pascalguttmann/obat-meas/README.md

# Obat - Measurement

KiCAD Project for the measurement electronics of Obat.

| TOP | BOT |
| --- | --- |
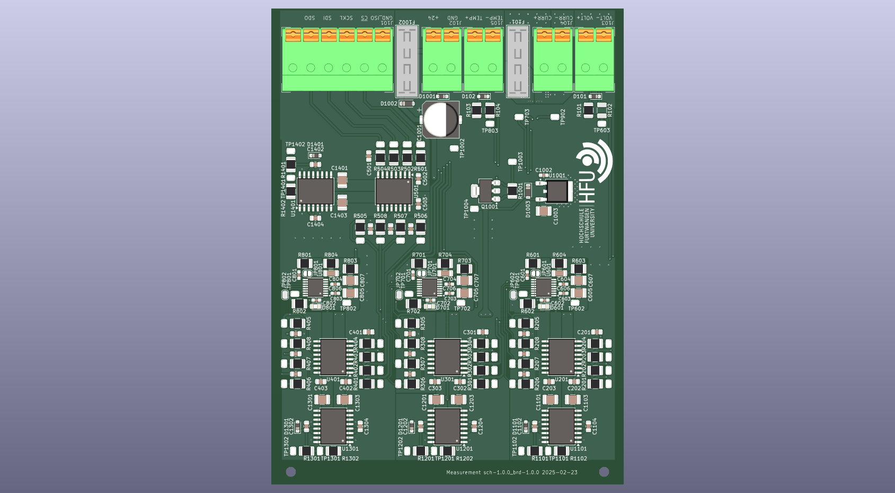
[picture p1: img/meas_top.png]
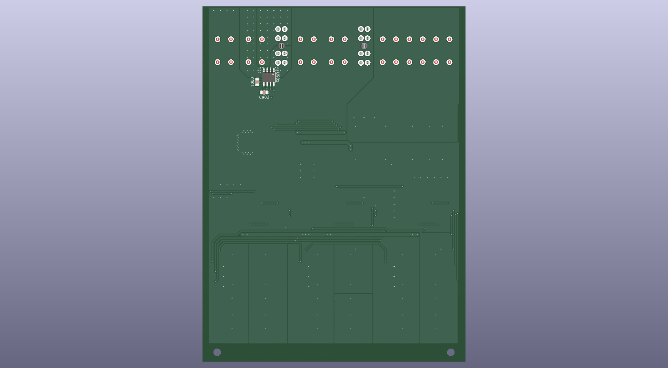
[picture p2: img/meas_bot.png]
|  |  |
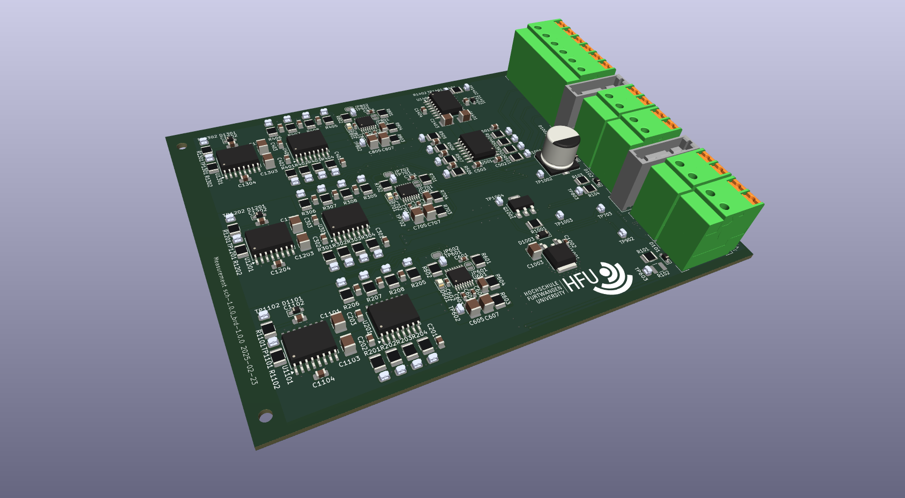
[picture p3: img/meas_3d_top.png]
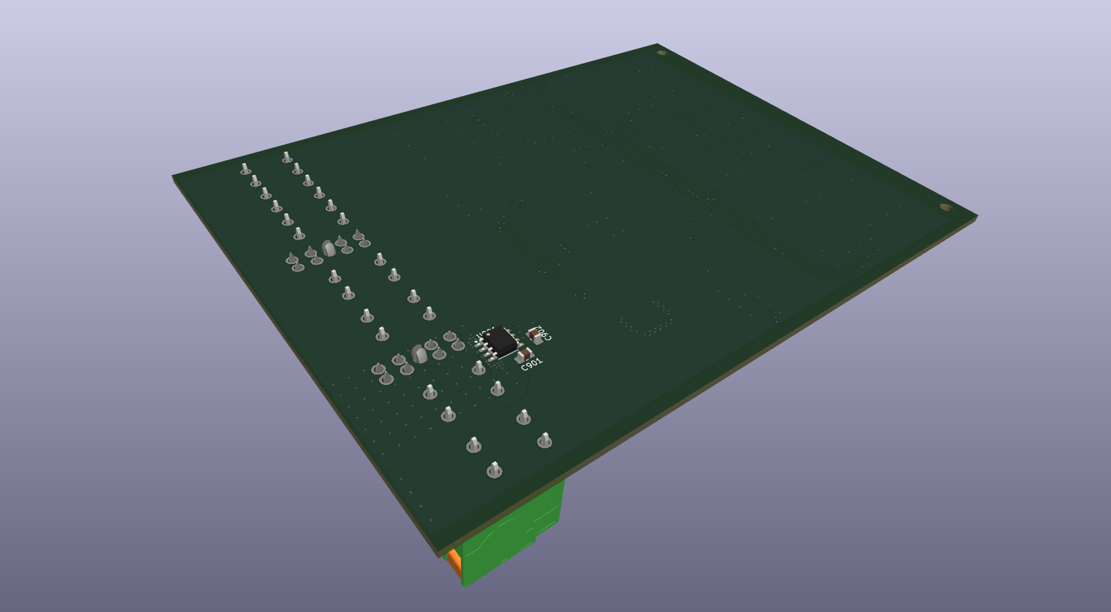
[picture p4: img/meas_3d_bot.png]
|  |  |

## License

This repository is licensed under the MIT license.
