pascalguttmann/obat-meas/3d_models/pxc_1017503_00_00_TDPT-2-5-2-SP-5-08_3D.stp

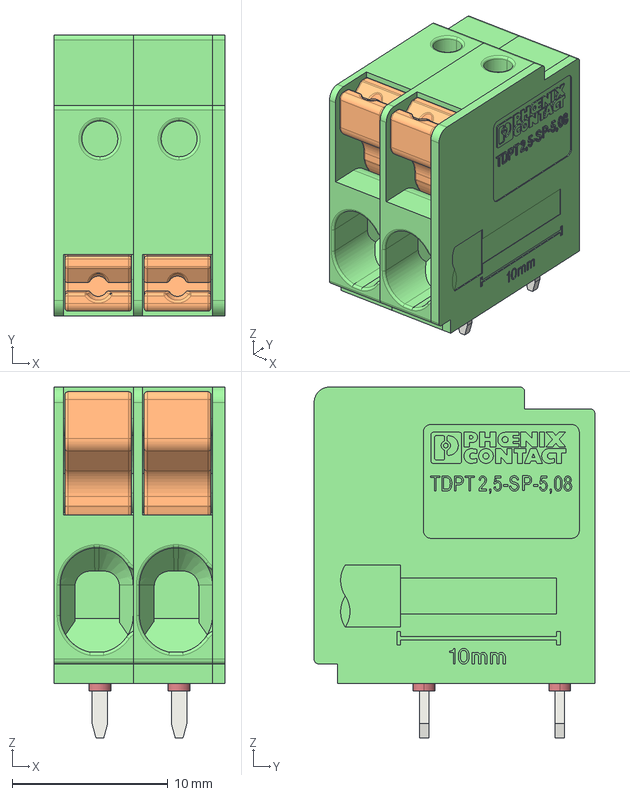
[picture p5: CAD file, 2025-02-22]
3d_models/pxc_1017503_00_00_TDPT-2-5-2-SP-5-08_3D.stp
11.0 x 18.0 x 22.5 mm
Bohrloch x 4
LP_TDPT_2_5_SP_DRST_vorne x 2
LP_TDPT_2_5_SP_DRST_hinten x 2
AC_TDPT_2_5_SP_pusher x 2
PK_TDPT_2_5_SP_GEH
PK_TDPT_2_5_SP_ENDGEH
DK_TDPT_2_5_SP
