pascalguttmann/obat-meas/3d_models/178.6165.0000.step

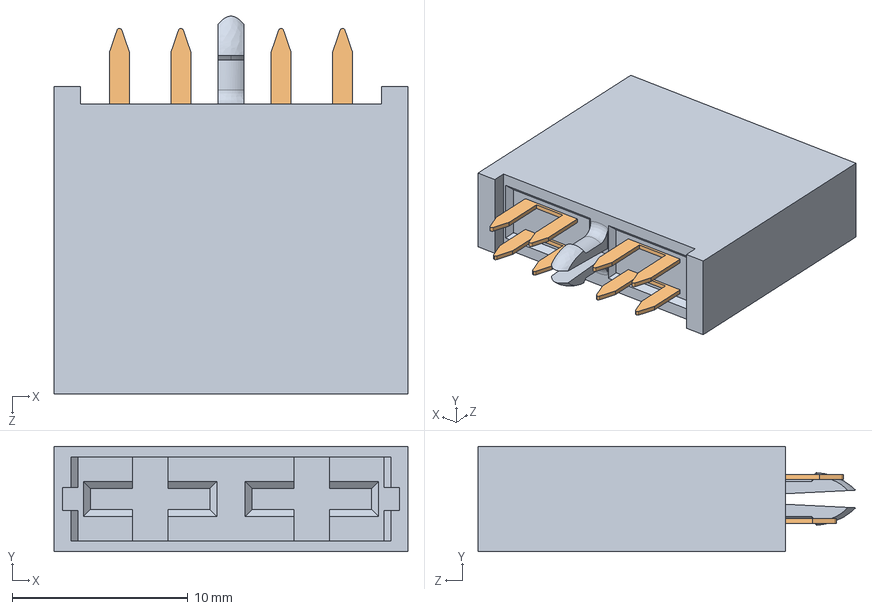
[picture p6: CAD file, 2025-02-22]
3d_models/178.6165.0000.step
20.1 x 6.00 x 21.5 mm
