pascalguttmann/obat-meas/3d_models/RCTCTE.STEP

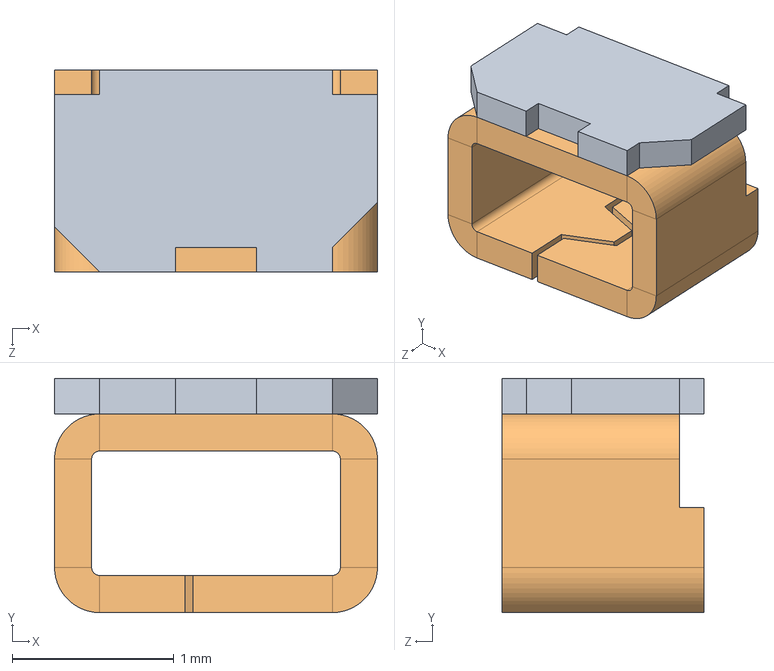
[picture p7: CAD file, 2025-02-22]
3d_models/RCTCTE.STEP
2.00 x 1.45 x 1.25 mm
