pascalguttmann/obat-meas/3d_models/pxc_1017507_00_00_TDPT-2-5-6-SP-5-08_3D.stp

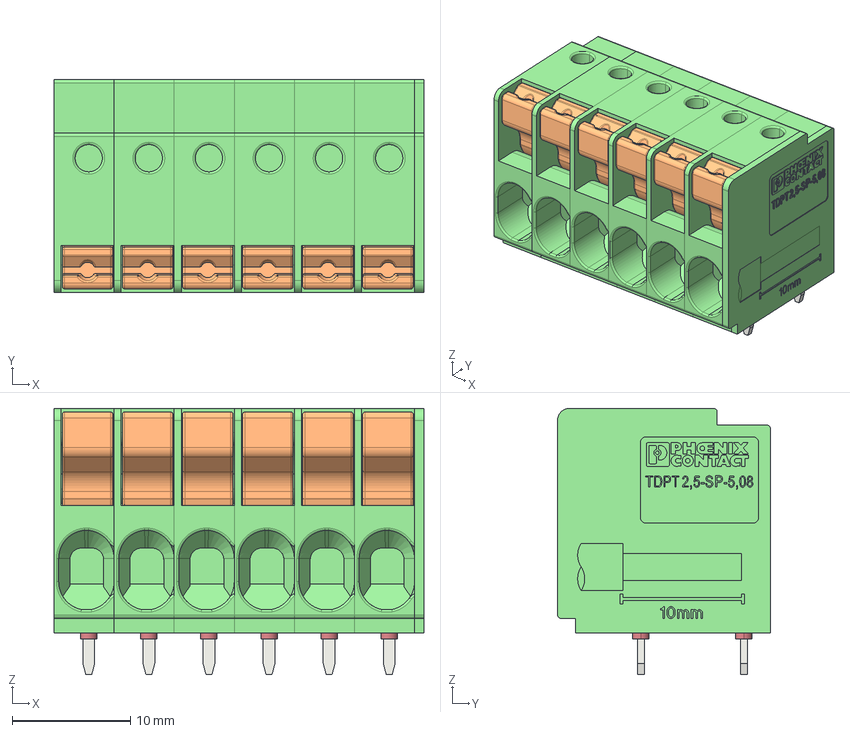
[picture p8: CAD file, 2025-02-22]
3d_models/pxc_1017507_00_00_TDPT-2-5-6-SP-5-08_3D.stp
31.3 x 18.0 x 22.5 mm
Bohrloch.2 x 12
LP_TDPT_2_5_SP_DRST_vorne.1 x 6
LP_TDPT_2_5_SP_DRST_hinten x 6
AC_TDPT_2_5_SP_pusher.1 x 6
PK_TDPT_2_5_SP_GEH x 5
PK_TDPT_2_5_SP_ENDGEH
DK_TDPT_2_5_SP
