pascalguttmann/obat-meas/schematic/meas_schematic_2.0.1.pdf

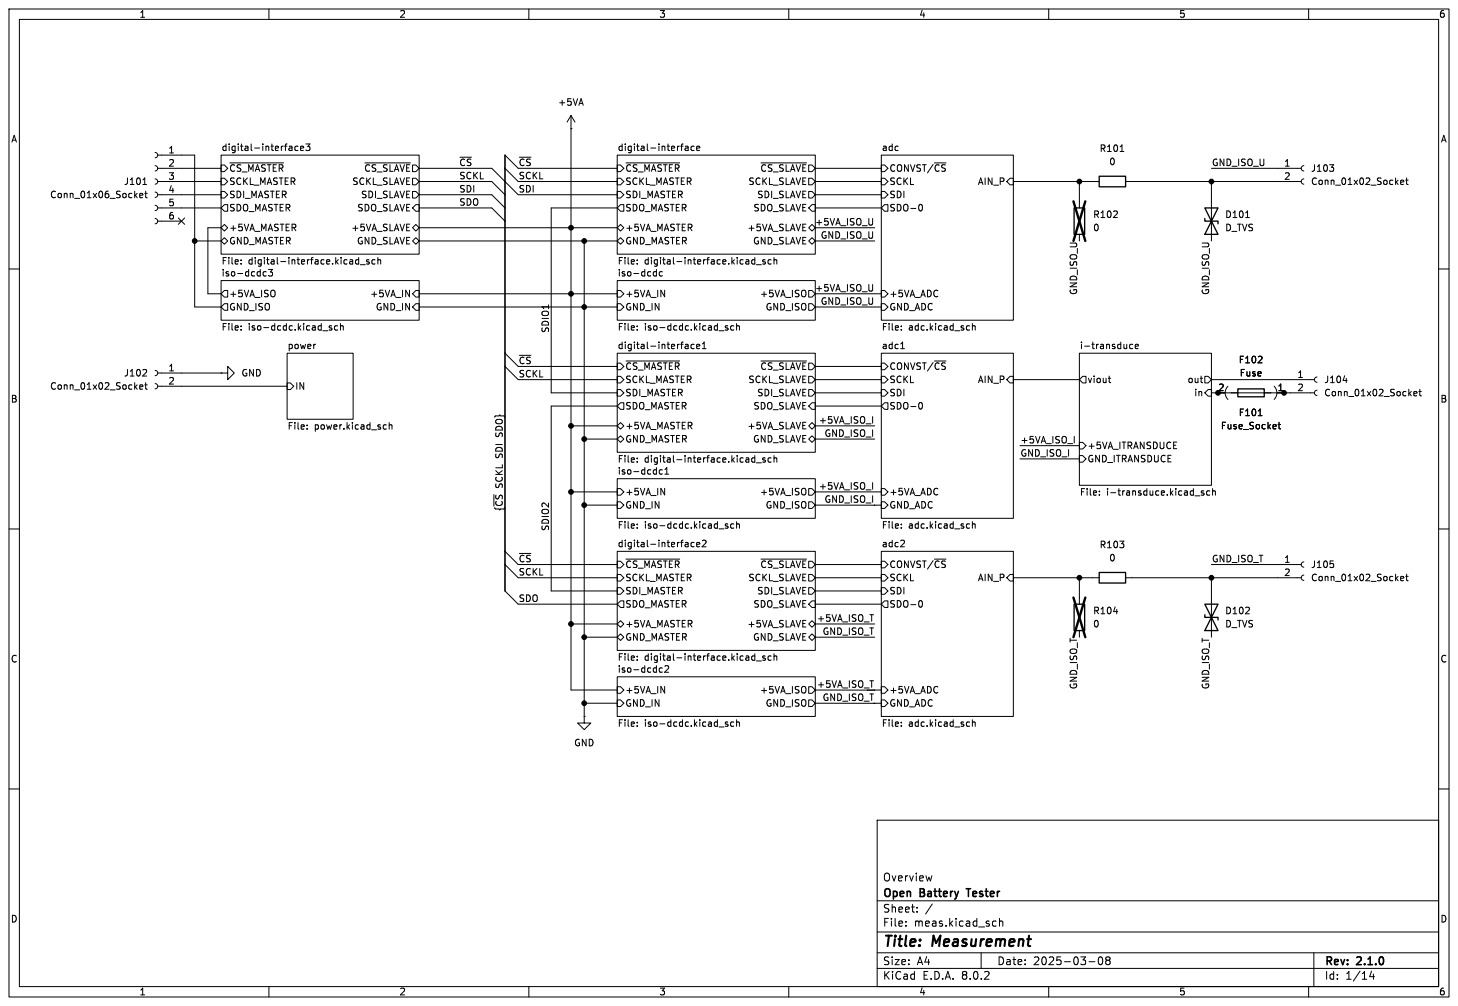
[picture p9: page 1]

SDI CONVST/~{CS} SCKL SDO-0 GND_ADC

iso-dcdc3 File: iso-dcdc.kicad_sch

+5VA_ISO_U

iso-dcdc1 File: iso-dcdc.kicad_sch

+5VA_ADC

digital-interface2 File: digital-interface.kicad_sch

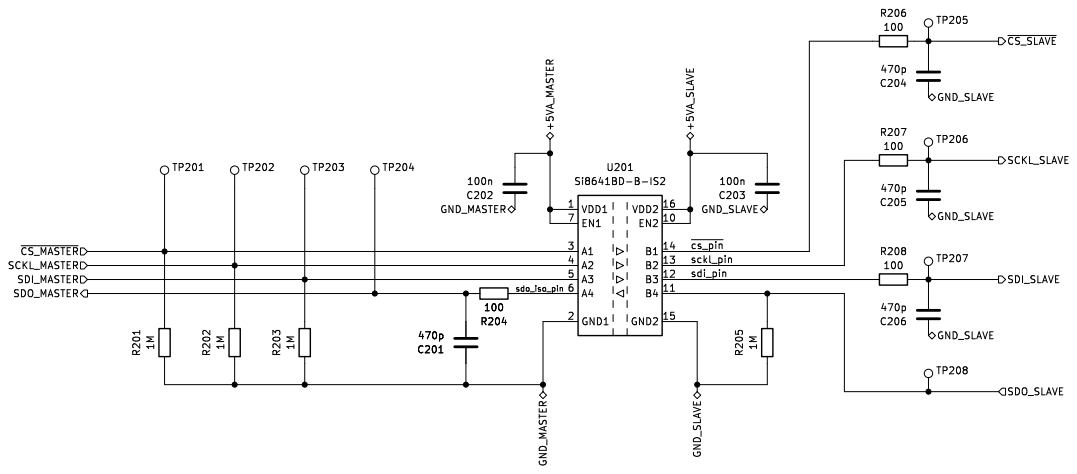
[picture p10: page 2]

Id: 2/14 Title: Measurement File: digital-interface.kicad_sch Sheet: /digital-interface/

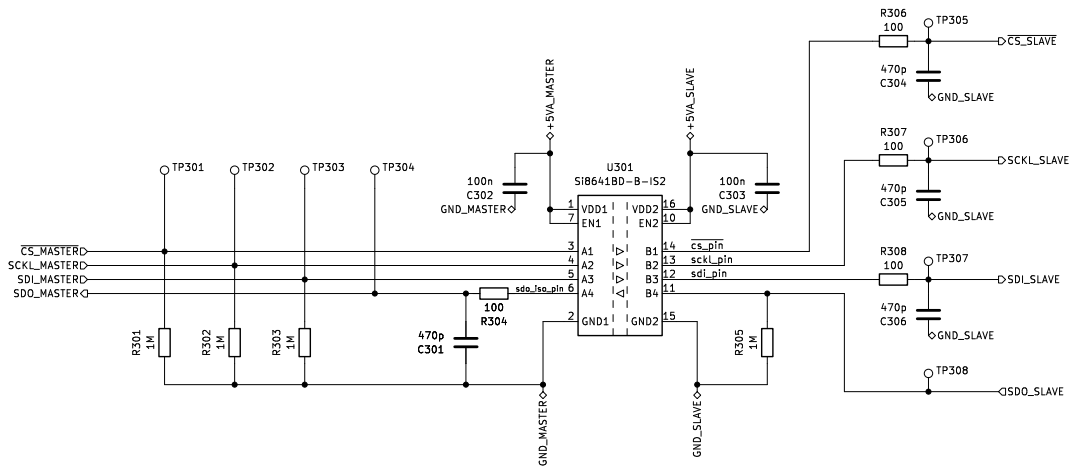
[picture p11: page 3]

Id: 3/14 Title: Measurement File: digital-interface.kicad_sch Sheet: /digital-interface1/

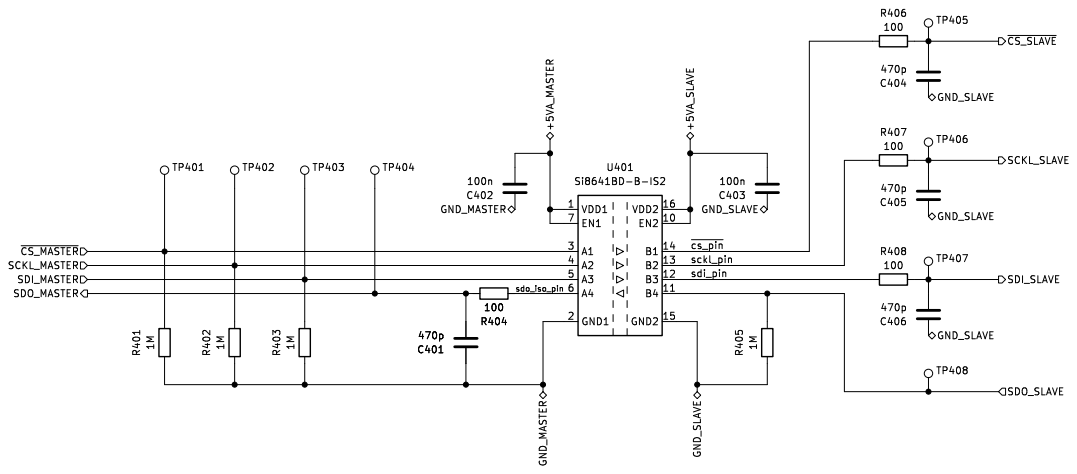
[picture p12: page 4]

Id: 4/14 Title: Measurement File: digital-interface.kicad_sch Sheet: /digital-interface2/

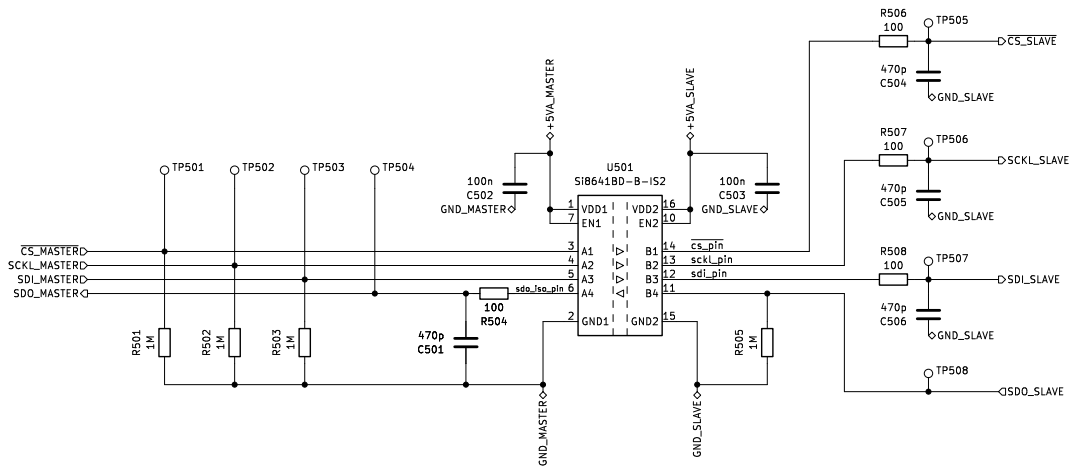
[picture p13: page 5]

Id: 5/14 Title: Measurement File: digital-interface.kicad_sch Sheet: /digital-interface3/

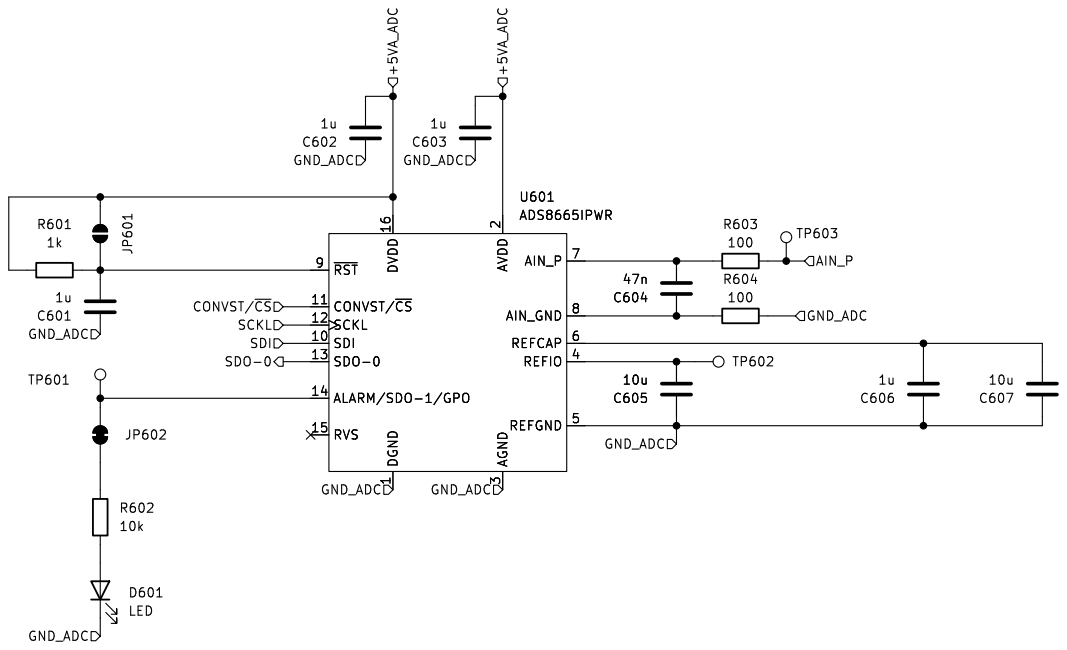
[picture p14: page 6]

3 REFIO 4 REFGND 5 REFCAP 6 AIN_P 7 AIN_GND 8 ~{RST} 9 U601 ADS8665IPWR

1 SDI 10 CONVST/~{CS} 11 SCKL 12 SDO-0 13 ALARM/SDO-1/GPO 14 RVS 15 DVDD 16 AVDD

3 REFIO 4 REFGND 5 REFCAP 6 AIN_P 7 AIN_GND 8 ~{RST} 9

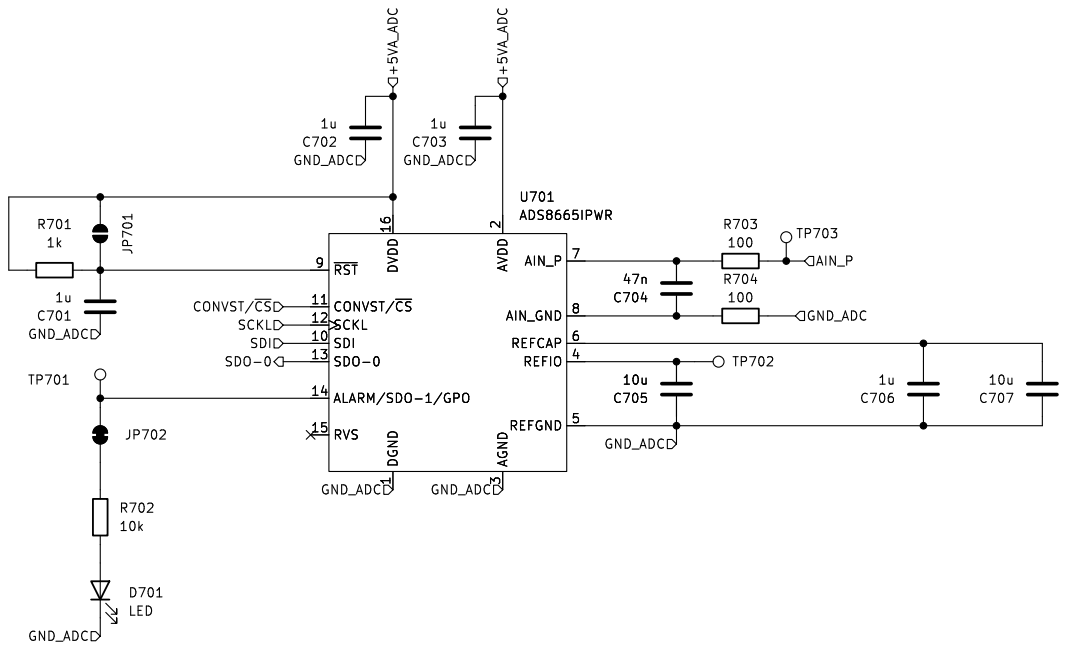
[picture p15: page 7]

3 REFIO 4 REFGND 5 REFCAP 6 AIN_P 7 AIN_GND 8 ~{RST} 9 U701 ADS8665IPWR

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

3 REFIO 4 REFGND 5 REFCAP 6 AIN_P 7 AIN_GND 8 ~{RST} 9

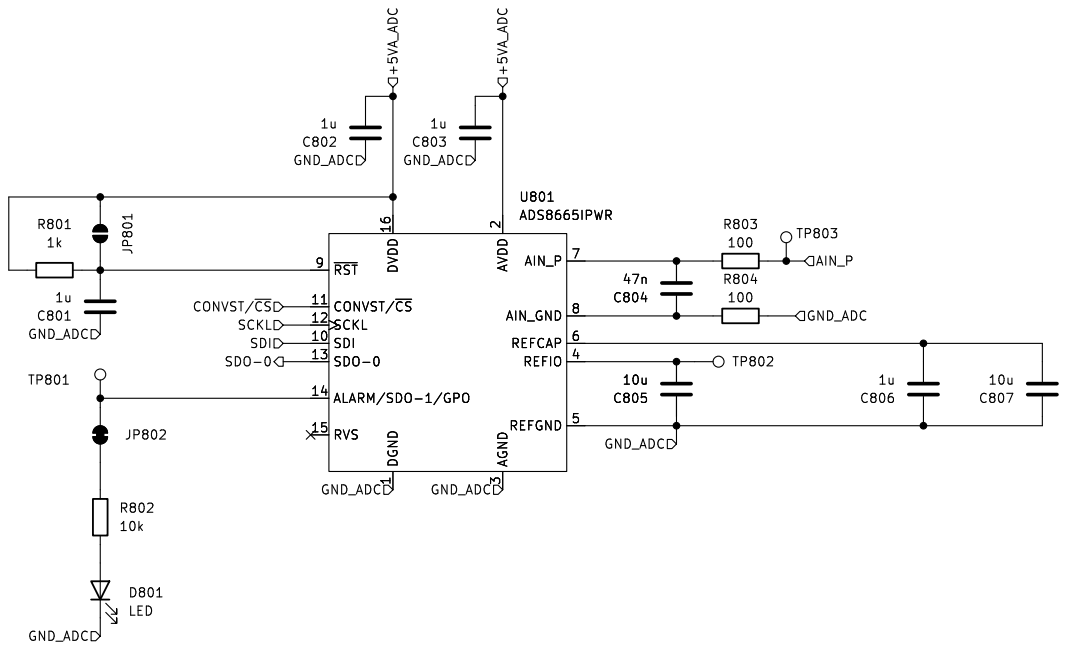
[picture p16: page 8]

3 REFIO 4 REFGND 5 REFCAP 6 AIN_P 7 AIN_GND 8 ~{RST} 9 U801 ADS8665IPWR

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

3 REFIO 4 REFGND 5 REFCAP 6 AIN_P 7 AIN_GND 8 ~{RST} 9

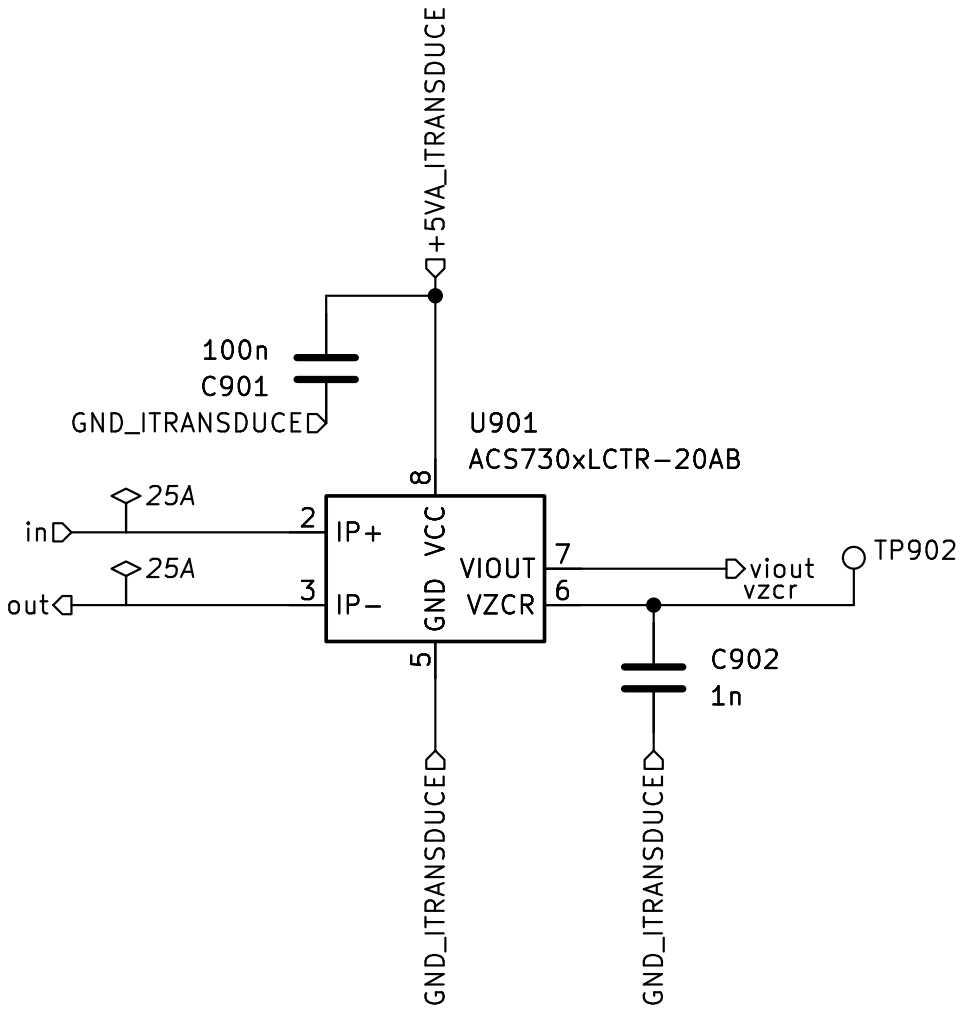
[picture p17: page 9]

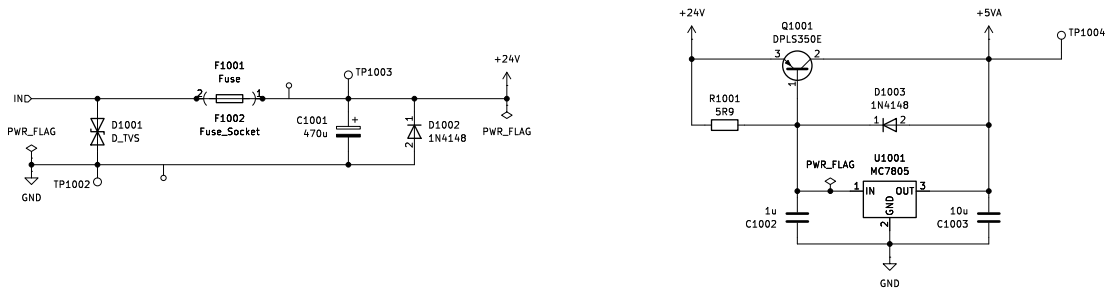
[picture p18: page 10]

Id: 10/14 Title: Measurement File: power.kicad_sch Sheet: /power/

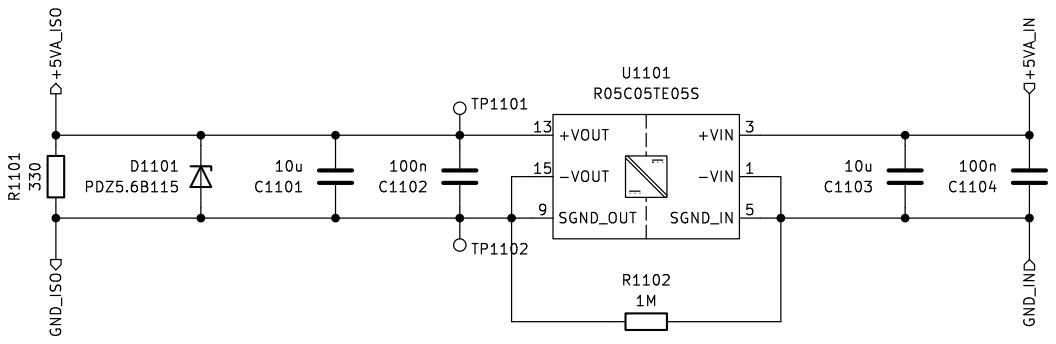
[picture p19: page 11]

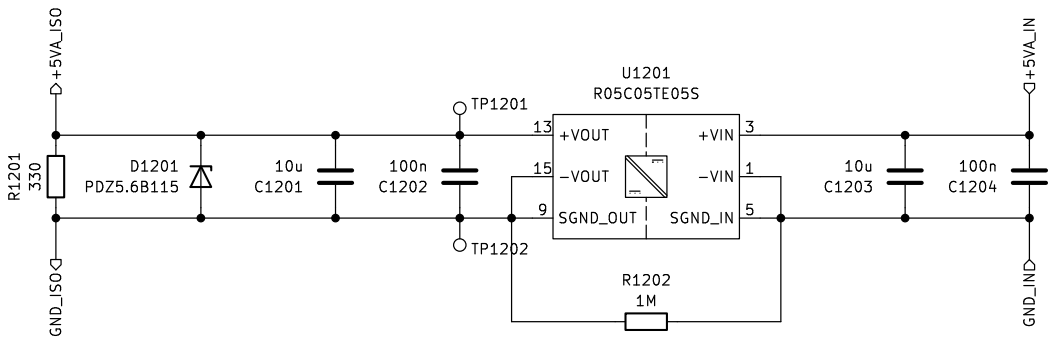
[picture p20: page 12]

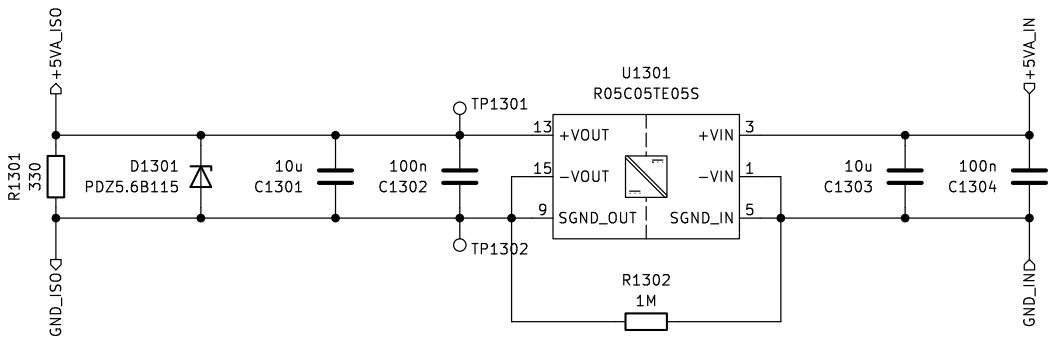
[picture p21: page 13]

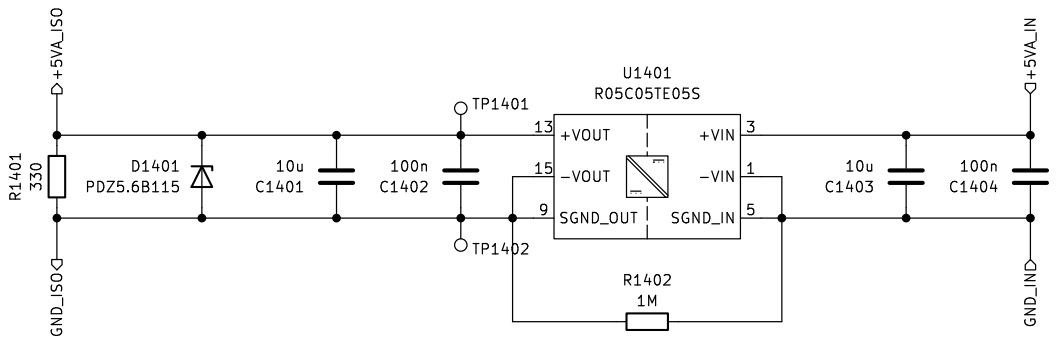
[picture p22: page 14]
