pascalguttmann/obat-meas/schematic/meas_schematic_2.0.0.pdf

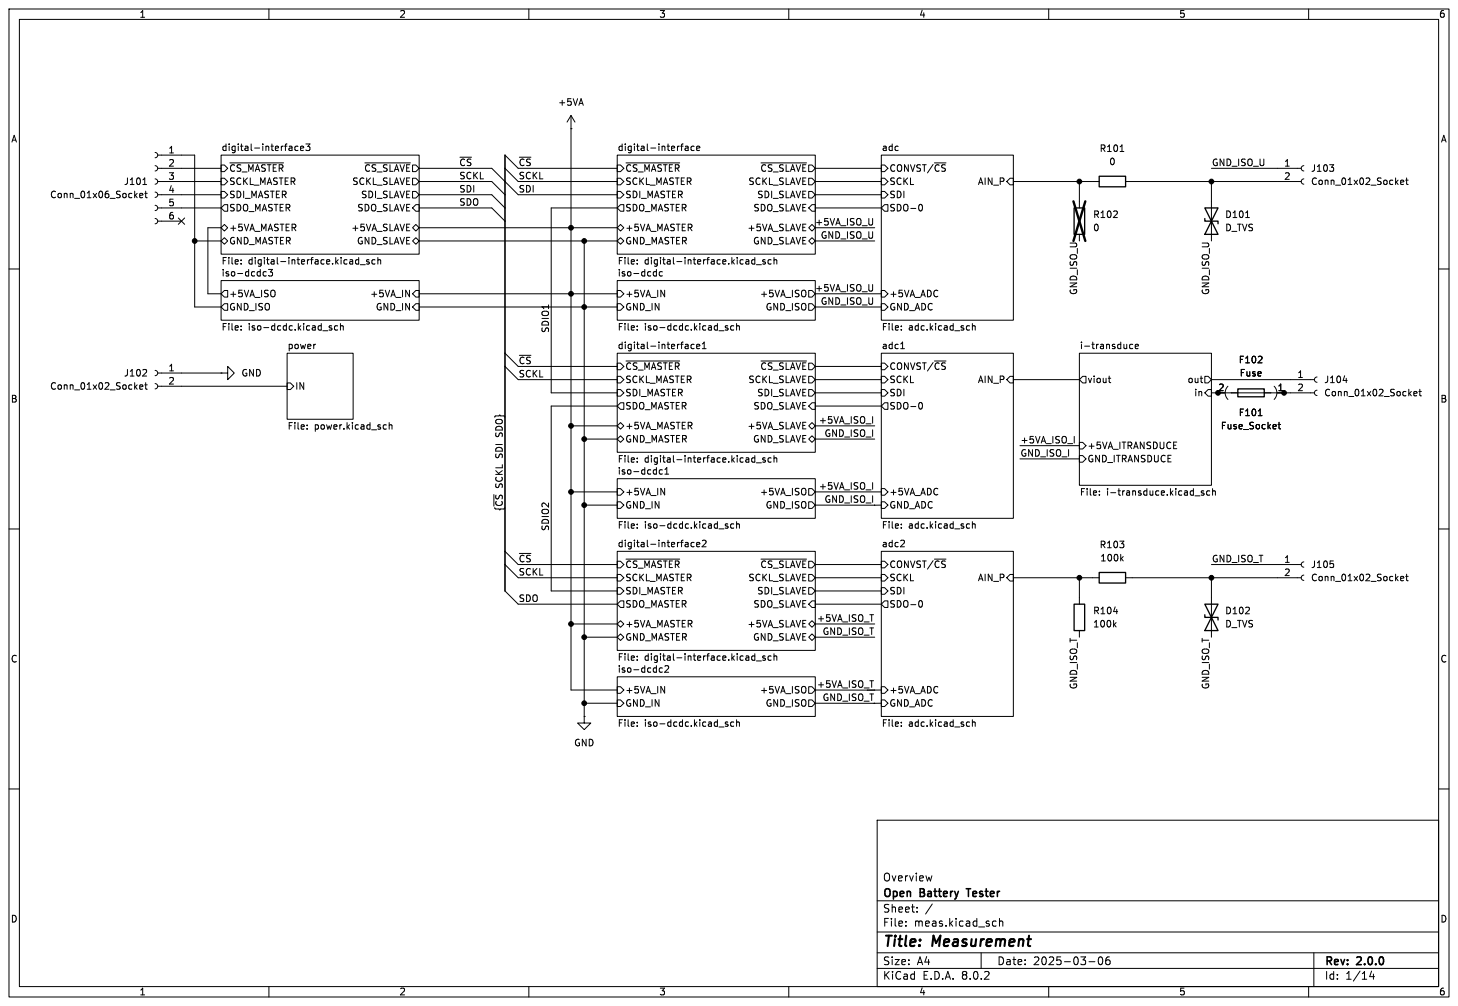
[picture p23: page 1]

SDI CONVST/~{CS} SCKL SDO-0 GND_ADC

iso-dcdc3 File: iso-dcdc.kicad_sch

+5VA_ISO_U

iso-dcdc1 File: iso-dcdc.kicad_sch

+5VA_ADC

digital-interface2 File: digital-interface.kicad_sch


Id: 2/14 Title: Measurement File: digital-interface.kicad_sch Sheet: /digital-interface/


Id: 3/14 Title: Measurement File: digital-interface.kicad_sch Sheet: /digital-interface1/


Id: 4/14 Title: Measurement File: digital-interface.kicad_sch Sheet: /digital-interface2/


Id: 5/14 Title: Measurement File: digital-interface.kicad_sch Sheet: /digital-interface3/


3 REFIO 4 REFGND 5 REFCAP 6 AIN_P 7 AIN_GND 8 ~{RST} 9 U601 ADS8665IPWR

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

3 REFIO 4 REFGND 5 REFCAP 6 AIN_P 7 AIN_GND 8 ~{RST} 9


3 REFIO 4 REFGND 5 REFCAP 6 AIN_P 7 AIN_GND 8 ~{RST} 9 U701 ADS8665IPWR

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

3 REFIO 4 REFGND 5 REFCAP 6 AIN_P 7 AIN_GND 8 ~{RST} 9


3 REFIO 4 REFGND 5 REFCAP 6 AIN_P 7 AIN_GND 8 ~{RST} 9 U801 ADS8665IPWR

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

3 REFIO 4 REFGND 5 REFCAP 6 AIN_P 7 AIN_GND 8 ~{RST} 9



Id: 10/14 Title: Measurement File: power.kicad_sch Sheet: /power/
