pascalguttmann/obat-meas/schematic/meas_schematic_1.0.0.pdf

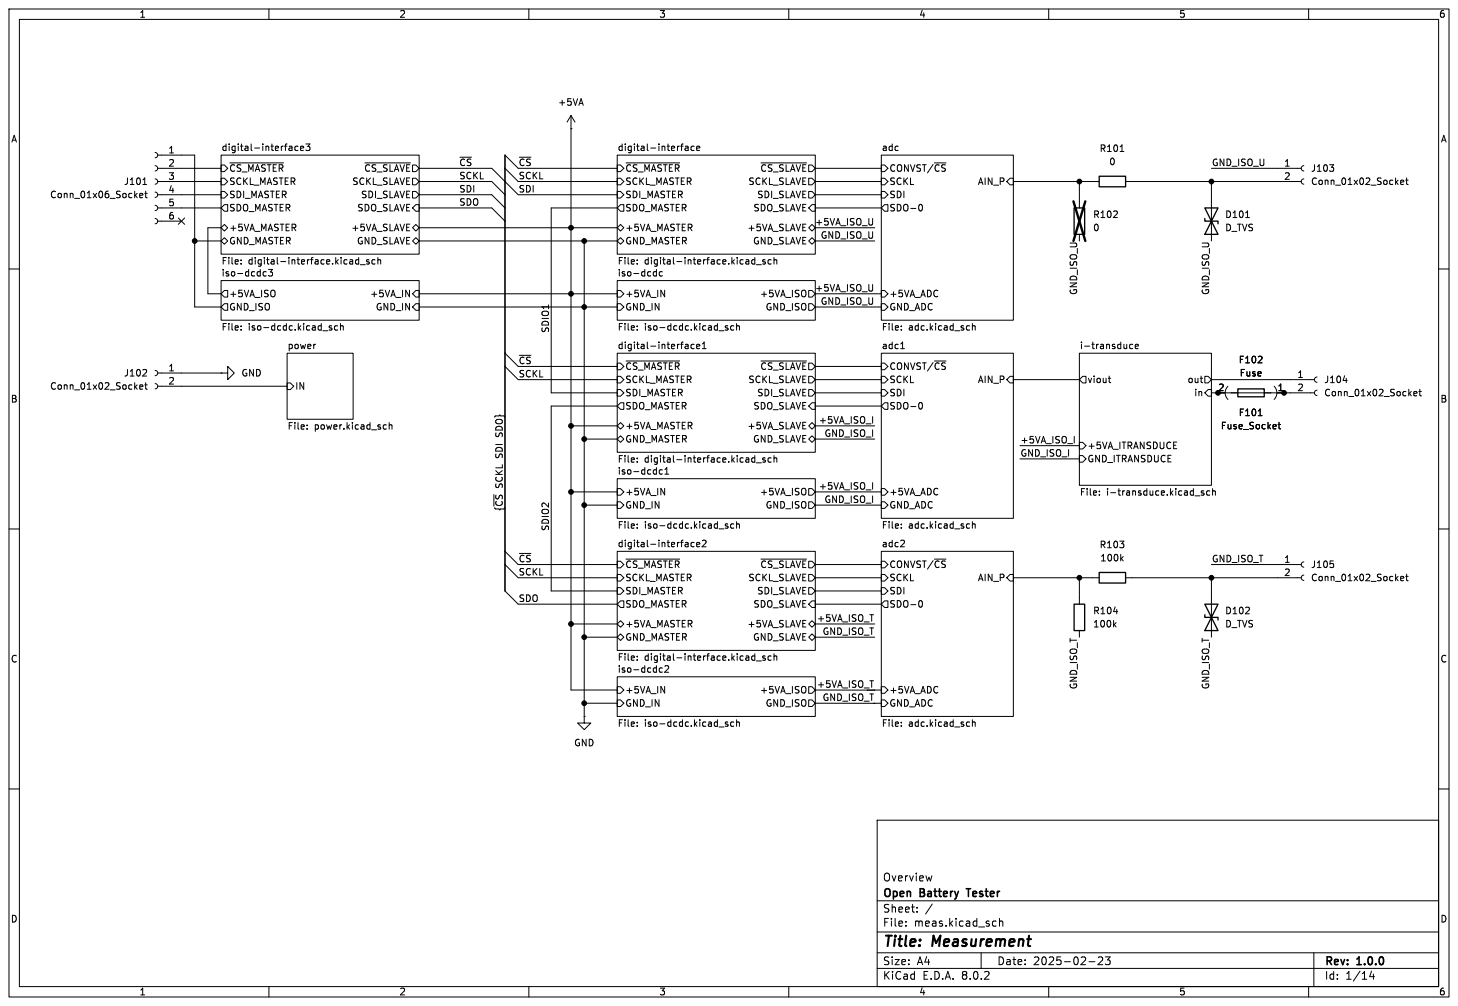
[picture p24: page 1]

digital-interface3 File: digital-interface.kicad_sch

adc File: adc.kicad_sch
SDI CONVST/~{CS} SCKL SDO-0 GND_ADC

+5VA_ISO


Id: 2/14 Title: Measurement File: digital-interface.kicad_sch Sheet: /digital-interface/


Id: 3/14 Title: Measurement File: digital-interface.kicad_sch Sheet: /digital-interface1/


Id: 4/14 Title: Measurement File: digital-interface.kicad_sch Sheet: /digital-interface2/


Id: 5/14 Title: Measurement File: digital-interface.kicad_sch Sheet: /digital-interface3/


3 REFIO 4 REFGND 5 REFCAP 6 AIN_P 7 AIN_GND 8 ~{RST} 9 U601 ADS8665IPWR

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

3 REFIO 4 REFGND 5 REFCAP 6 AIN_P 7 AIN_GND 8 ~{RST} 9


3 REFIO 4 REFGND 5 REFCAP 6 AIN_P 7 AIN_GND 8 ~{RST} 9 U701 ADS8665IPWR

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

3 REFIO 4 REFGND 5 REFCAP 6 AIN_P 7 AIN_GND 8 ~{RST} 9


3 REFIO 4 REFGND 5 REFCAP 6 AIN_P 7 AIN_GND 8 ~{RST} 9 U801 ADS8665IPWR

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

3 REFIO 4 REFGND 5 REFCAP 6 AIN_P 7 AIN_GND 8 ~{RST} 9



Id: 10/14 Title: Measurement File: power.kicad_sch Sheet: /power/
