pascalguttmann/obat-meas/board/brd-1.0.0/meas-B_Cu.pdf

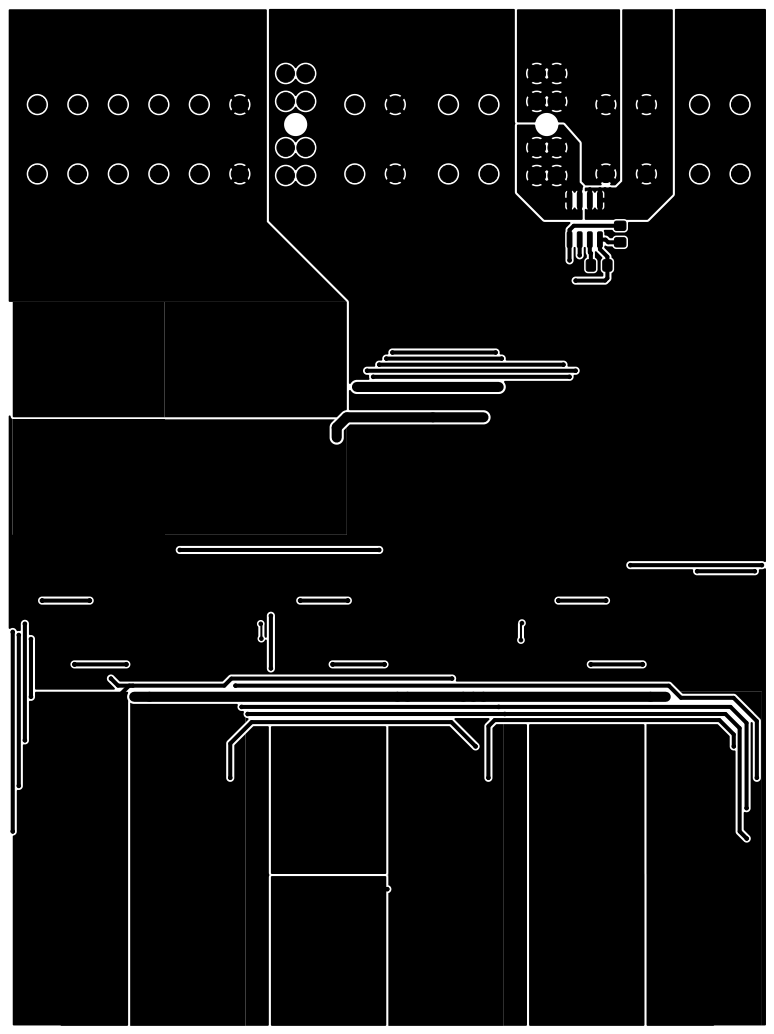
[picture p25: page 1]
