pascalguttmann/obat-meas/board/brd-1.0.0/meas-B_Mask.pdf

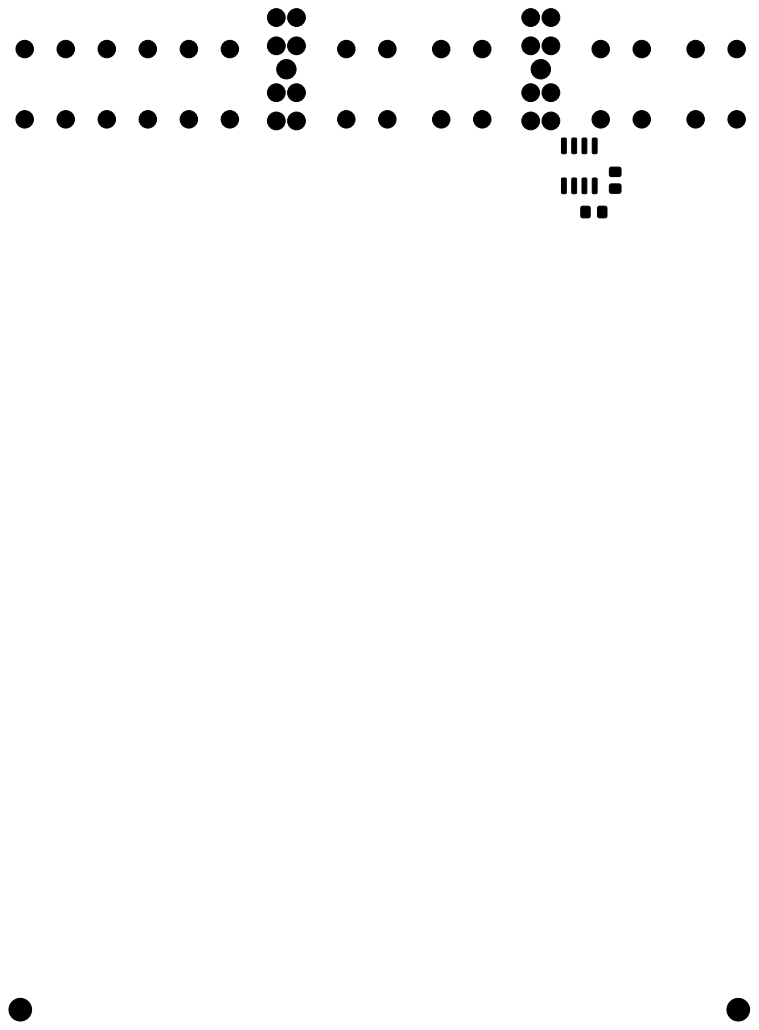
[picture p26: page 1]
