pascalguttmann/obat-meas/board/brd-1.0.0/meas-B_Paste.pdf

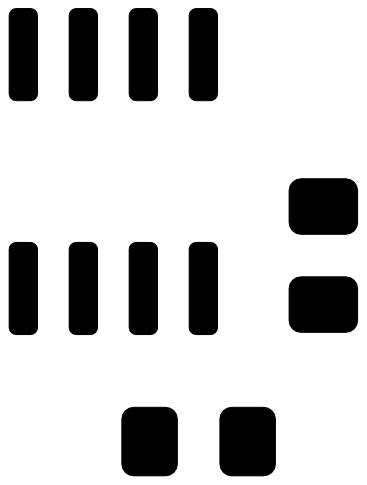
[picture p27: page 1]
