pascalguttmann/obat-meas/board/brd-1.0.0/meas-B_Silkscreen.pdf

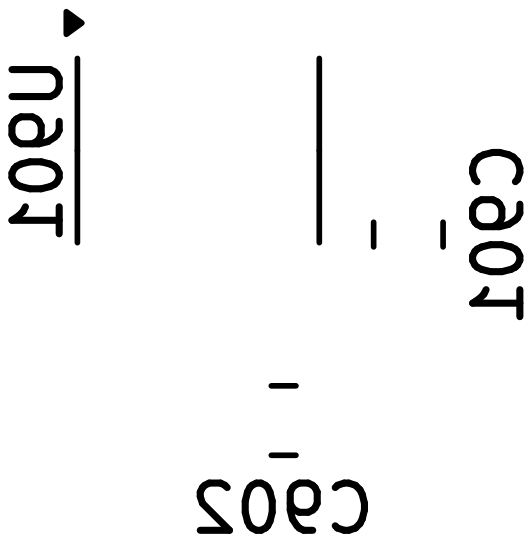
[picture p28: page 1]
