pascalguttmann/obat-meas/board/brd-1.0.0/meas-Edge_Cuts.pdf

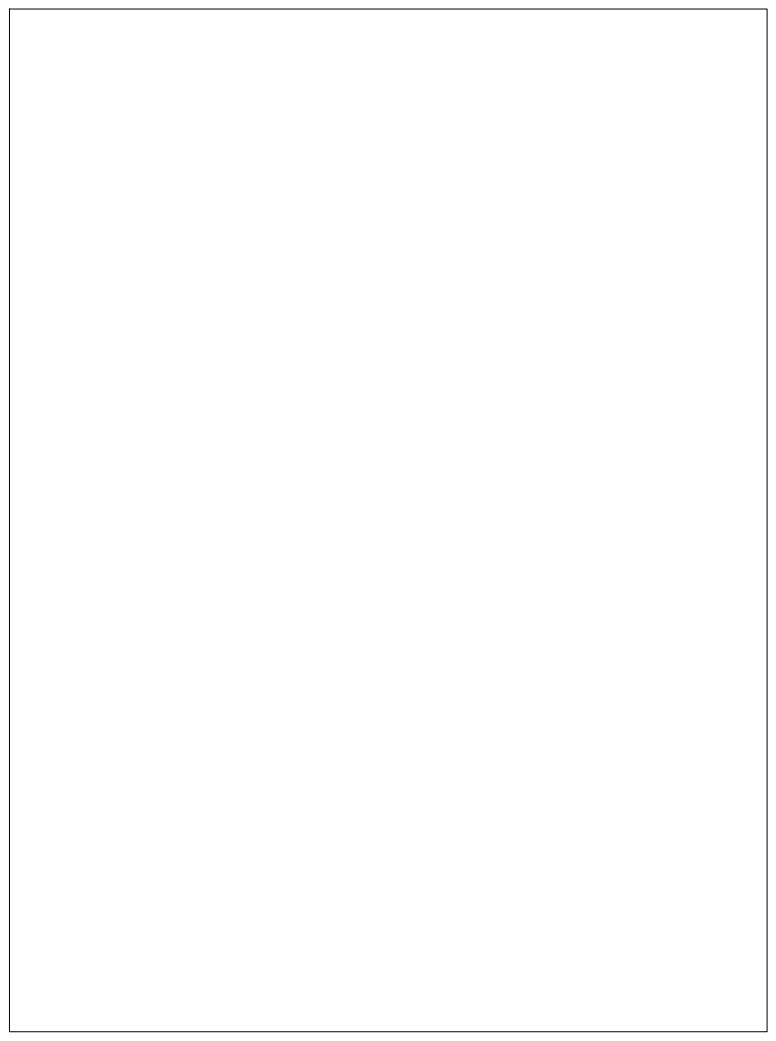
[picture p29: page 1]
