pascalguttmann/obat-meas/board/brd-1.0.0/meas-F_Cu.pdf

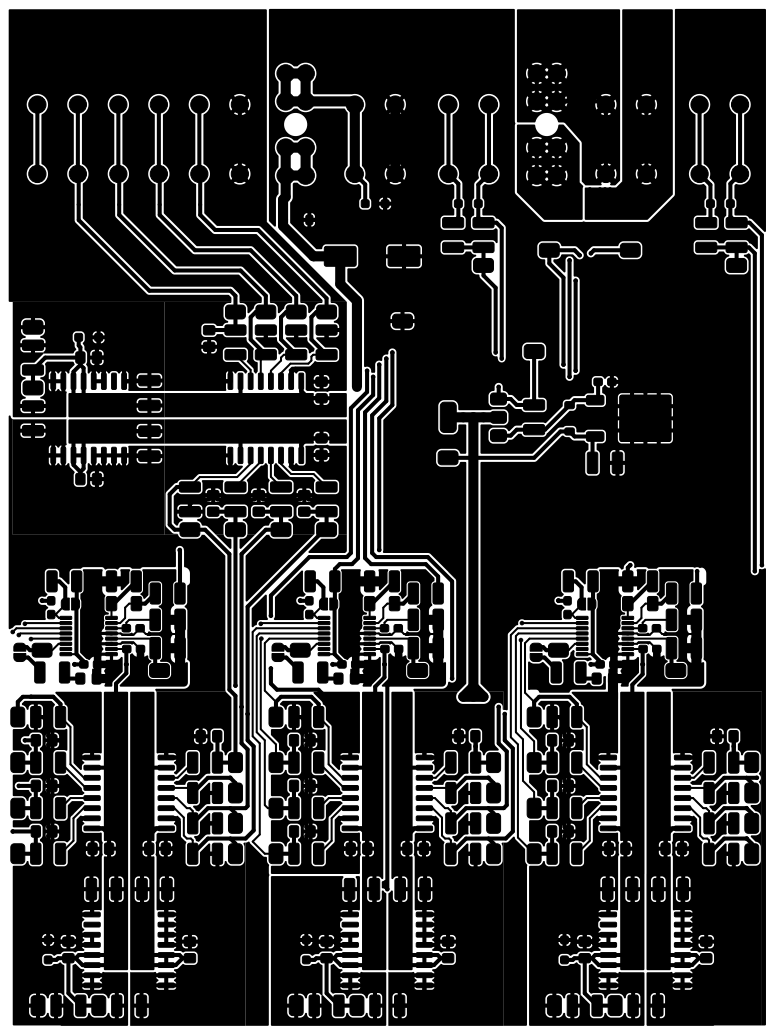
[picture p30: page 1]
