pascalguttmann/obat-meas/board/brd-1.0.0/meas-F_Mask.pdf

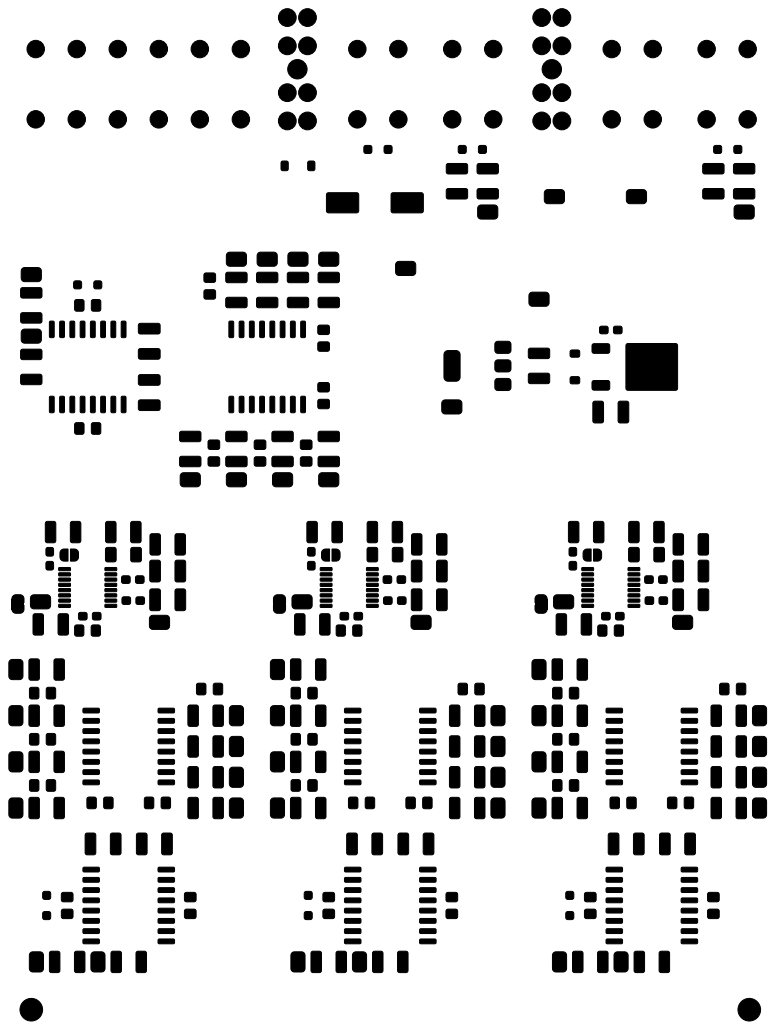
[picture p31: page 1]
