pascalguttmann/obat-meas/board/brd-1.0.0/meas-F_Paste.pdf

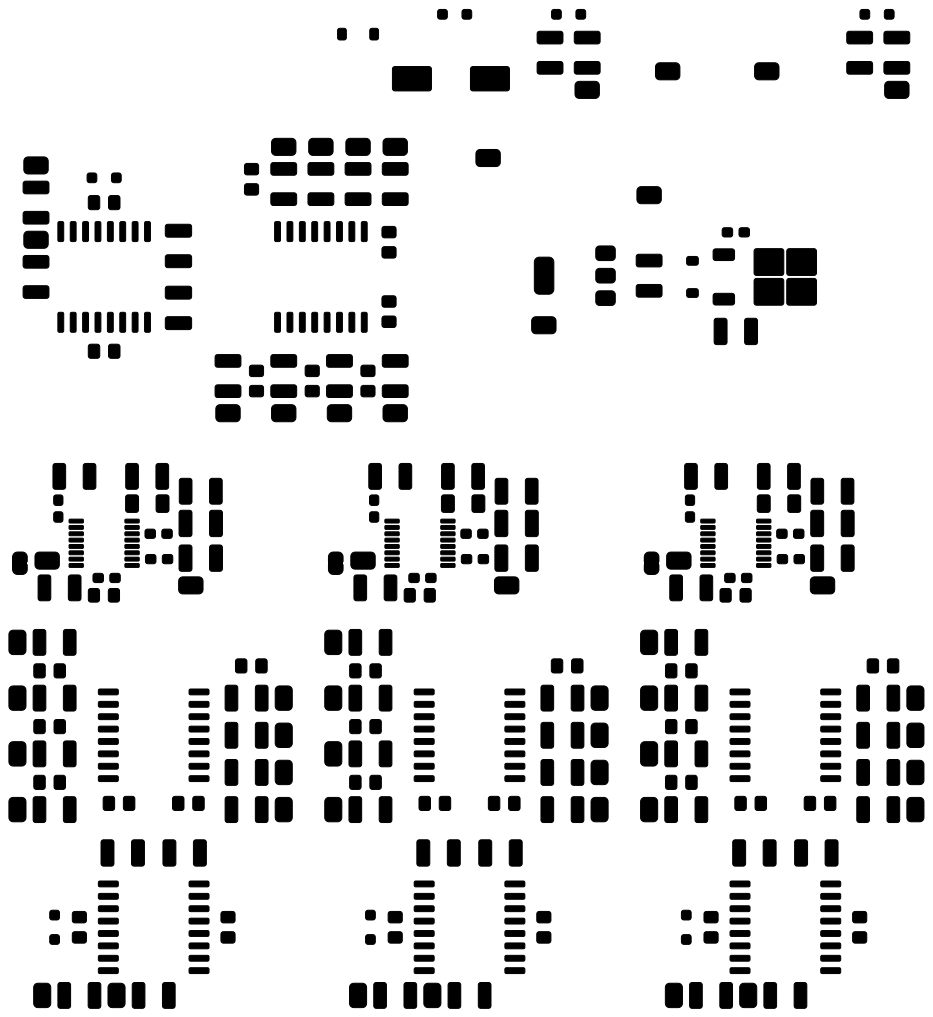
[picture p32: page 1]
