pascalguttmann/obat-meas/board/brd-1.0.0/meas-F_Silkscreen.pdf

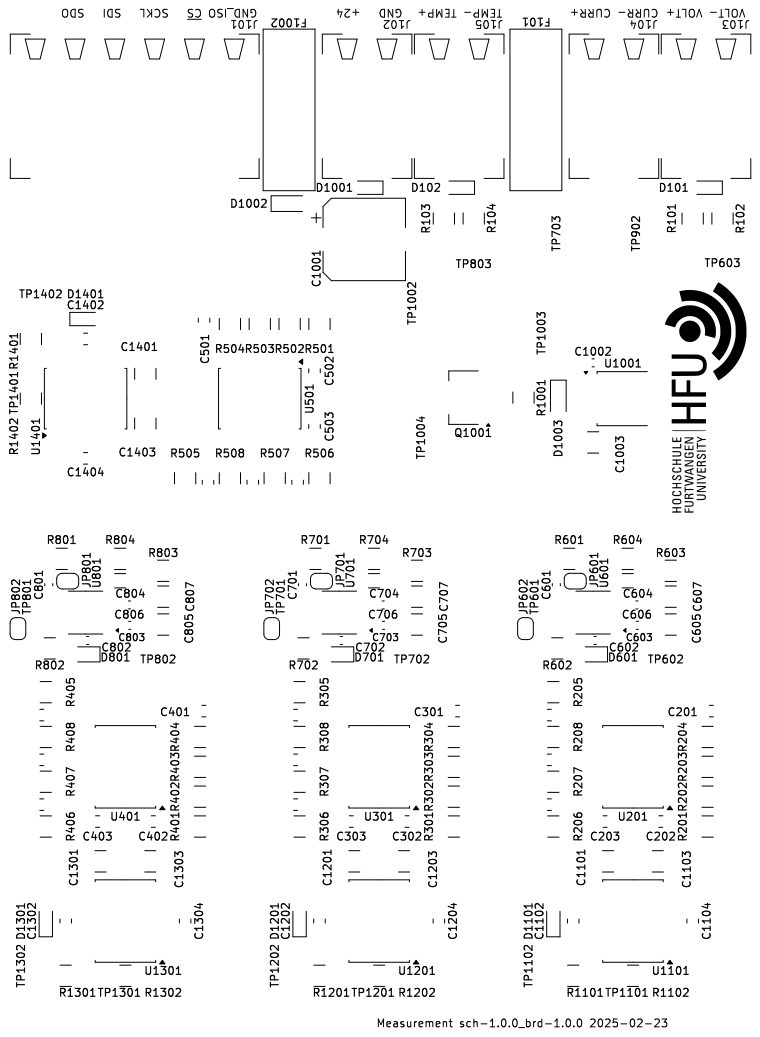
[picture p33: page 1]
