pascalguttmann/obat-meas/meas.kicad_pcb

## KiCad design meas.kicad_pcb (2025-03-06)

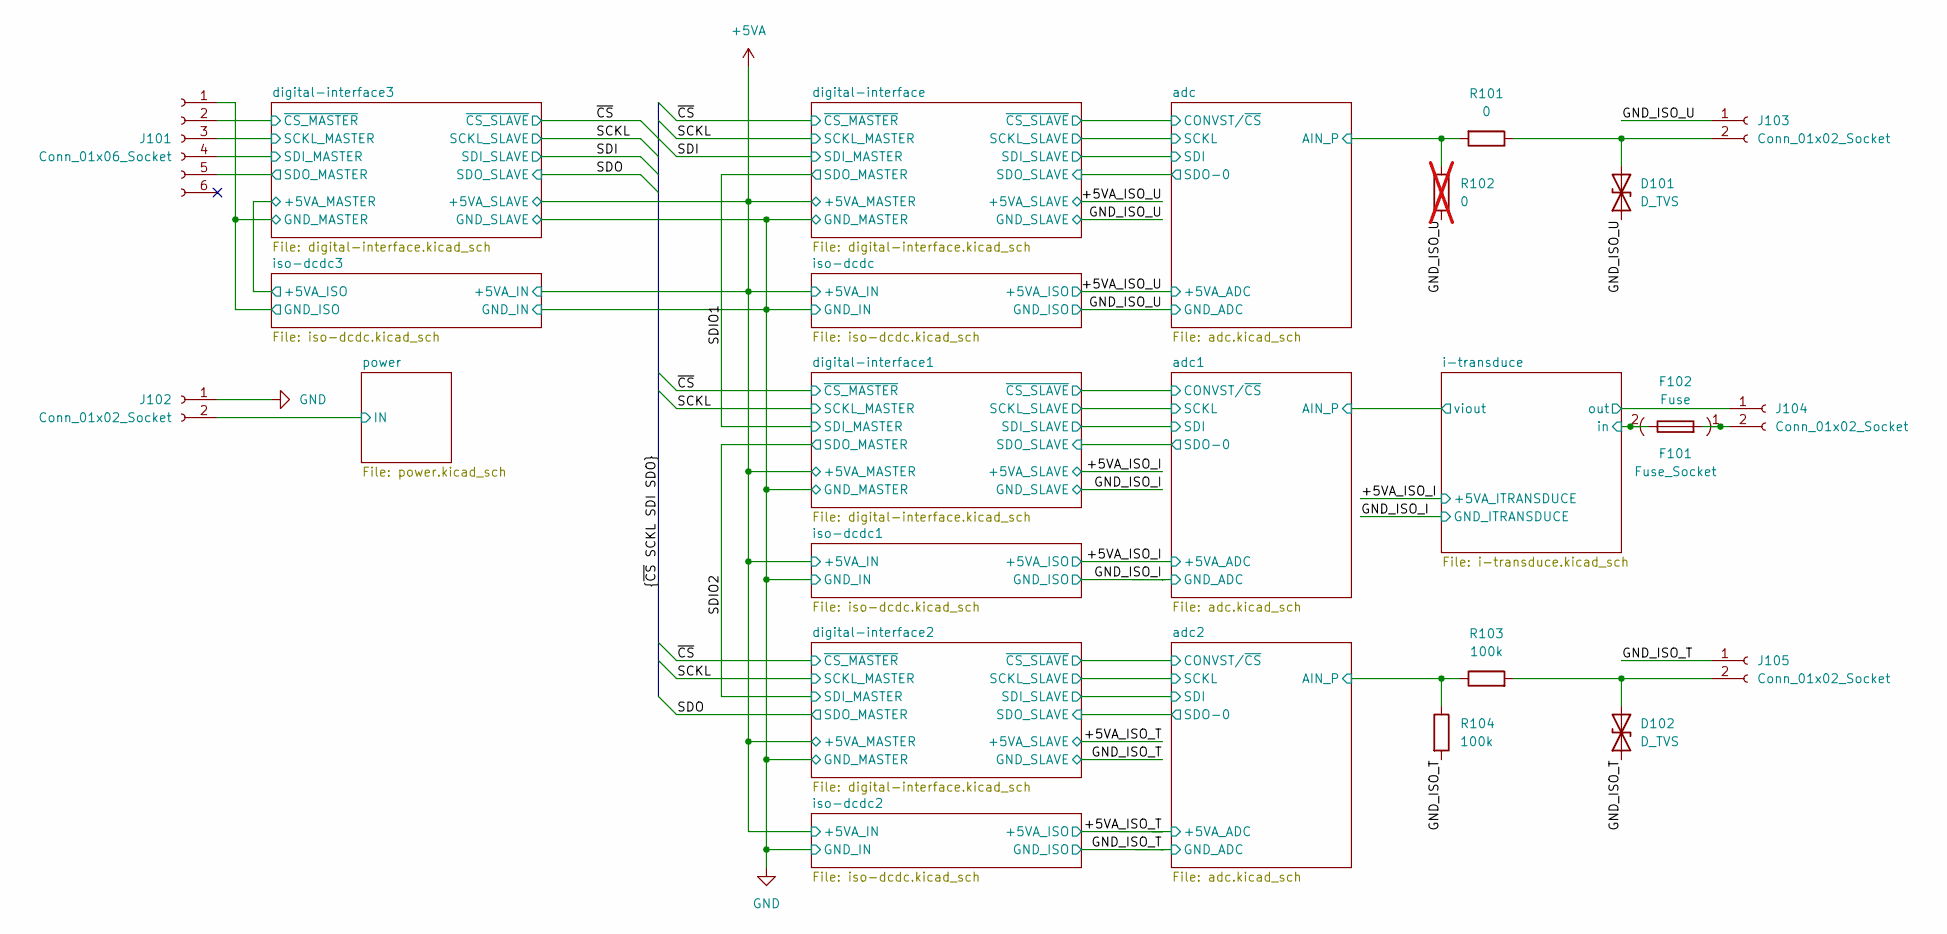
[picture p34: schematic meas.kicad_sch, Measurement]

Parts:
D101, D102: D_TVS; D_SOD-323_HandSoldering; MPN UDD32C24L01
F101: Fuse_Socket; FuseHolder_Blade_ATO_Littelfuse_FLR_178.6165; MPN 178.6165.0002
F102: Fuse; MPN 0287030.PXCN
J101: Conn_01x06_Socket; PhoenixContact_TDPT_2,5_6-SP-5,08_1x06_P5.08mm_Horizontal; MPN 1017507
J102, J103, J104, J105: Conn_01x02_Socket; PhoenixContact_TDPT_2,5_2-SP-5,08_1x02_P5.08mm_Horizontal; MPN 1017503
R101: 0; R_1210_3225Metric_Pad1.30x2.65mm_HandSolder; MPN RC1210JR-070RL
R102: 0; R_1210_3225Metric_Pad1.30x2.65mm_HandSolder; MPN RC1210JR-070RL; not fitted
R103, R104: 100k; R_1210_3225Metric_Pad1.30x2.65mm_HandSolder; MPN RC1210FR-07100KL

Connections:
/GND_ISO_T: D102.1 (A1), J105.1, R104.2; also elsewhere on the board
/GND_ISO_U: D101.1 (A1), J103.1, R102.1; also elsewhere on the board
/adc2/AIN_P: R103.1, R104.1; also elsewhere on the board
/adc/AIN_P: R101.2, R102.2; also elsewhere on the board
/digital-interface3/GND_MASTER: J101.1; also elsewhere on the board
/digital-interface3/SCKL_MASTER: J101.3; also elsewhere on the board
/digital-interface3/SDI_MASTER: J101.4; also elsewhere on the board
/digital-interface3/SDO_MASTER: J101.5; also elsewhere on the board
/digital-interface3/~CS_MASTER: J101.2; also elsewhere on the board
/i-transduce/in: F101.2, F102.1; also elsewhere on the board
/i-transduce/out: J104.1; also elsewhere on the board
/power/IN: J102.2; also elsewhere on the board
GND: J102.1; also elsewhere on the board
unnamed: D101.2 (A2), J103.2, R101.1
unnamed: D102.2 (A2), J105.2, R103.2
unnamed: F101.1, F102.2, J104.2

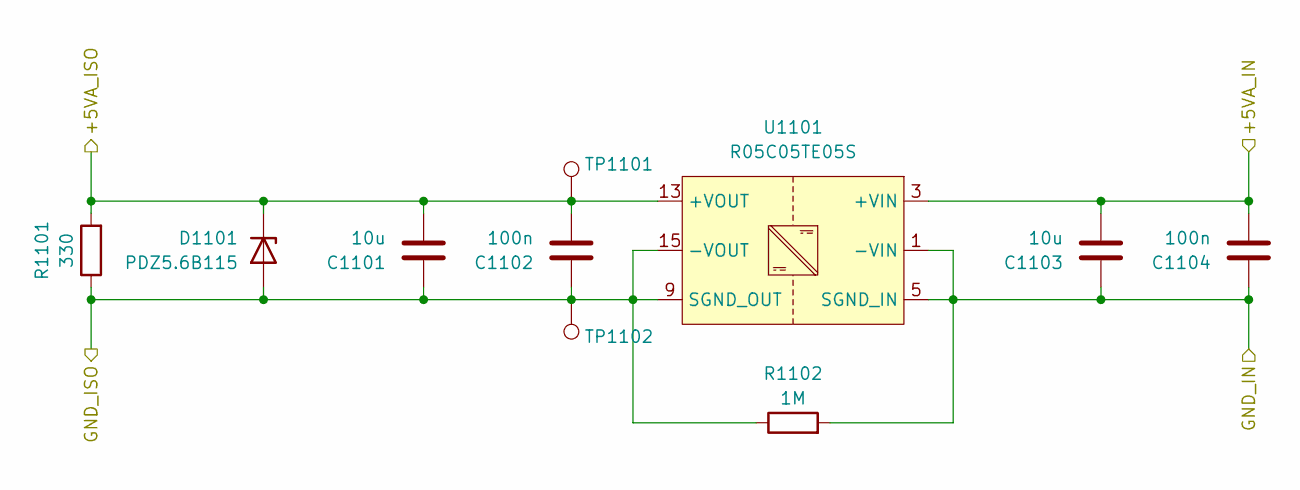
[picture p35: schematic iso-dcdc.kicad_sch, Measurement]

Parts:
C1101, C1103: 10u; C_1210_3225Metric_Pad1.33x2.70mm_HandSolder; MPN C1210C106K3RACTU
C1102, C1104: 100n; C_0805_2012Metric_Pad1.18x1.45mm_HandSolder; MPN C0805C104K3RACTU
D1101: PDZ5.6B115; D_SOD-323_HandSoldering; MPN PDZ5.6B,115
R1101: 330; R_1210_3225Metric_Pad1.30x2.65mm_HandSolder; MPN RC1210FR-07330RL
R1102: 1M; R_1210_3225Metric_Pad1.30x2.65mm_HandSolder; MPN RC1210FR-071ML
TP1101, TP1102: TP_0805_2012Metric; MPN RCTCTE
U1101: R05C05TE05S; SOIC-16W_7.5x10.3mm_P1.27mm; MPN R05C05TE05S-R

Connections:
/+5VA_ISO_U: C1101.2, C1102.2, D1101.1 (K), R1101.2, TP1101.1, U1101.13 (+VOUT), U1101.14 (+VOUT); also elsewhere on the board
/GND_ISO_U: C1101.1, C1102.1, D1101.2 (A), R1101.1, R1102.1, TP1102.1, U1101.9 (SGND_OUT), U1101.11 (SGND_OUT), U1101.12 (SGND_OUT), U1101.15 (-VOUT), U1101.16 (-VOUT); also elsewhere on the board
GND: C1103.1, C1104.1, R1102.2, U1101.1 (-VIN), U1101.2 (-VIN), U1101.5 (SGND_IN), U1101.6 (SGND_IN), U1101.7 (SGND_IN), U1101.8 (SGND_IN); also elsewhere on the board

Parts of its further copies:
C1201, C1203, C1301, C1303, C1401, C1403: 10u; C_1210_3225Metric_Pad1.33x2.70mm_HandSolder; MPN C1210C106K3RACTU
C1202, C1204, C1302, C1304, C1402, C1404: 100n; C_0805_2012Metric_Pad1.18x1.45mm_HandSolder; MPN C0805C104K3RACTU
D1201, D1301, D1401: PDZ5.6B115; D_SOD-323_HandSoldering; MPN PDZ5.6B,115
R1201, R1301, R1401: 330; R_1210_3225Metric_Pad1.30x2.65mm_HandSolder; MPN RC1210FR-07330RL
R1202, R1302, R1402: 1M; R_1210_3225Metric_Pad1.30x2.65mm_HandSolder; MPN RC1210FR-071ML
TP1201, TP1202, TP1301, TP1302, TP1401, TP1402: TP_0805_2012Metric; MPN RCTCTE
U1201, U1301, U1401: R05C05TE05S; SOIC-16W_7.5x10.3mm_P1.27mm; MPN R05C05TE05S-R

Connections of its further copies:
/+5VA_ISO_I: C1201.2, C1202.2, D1201.1 (K), R1201.2, TP1201.1, U1201.13 (+VOUT), U1201.14 (+VOUT); also elsewhere on the board
/+5VA_ISO_T: C1301.2, C1302.2, D1301.1 (K), R1301.2, TP1301.1, U1301.13 (+VOUT), U1301.14 (+VOUT); also elsewhere on the board
/GND_ISO_I: C1201.1, C1202.1, D1201.2 (A), R1201.1, R1202.1, TP1202.1, U1201.9 (SGND_OUT), U1201.11 (SGND_OUT), U1201.12 (SGND_OUT), U1201.15 (-VOUT), U1201.16 (-VOUT); also elsewhere on the board
/GND_ISO_T: C1301.1, C1302.1, D1301.2 (A), R1301.1, R1302.1, TP1302.1, U1301.9 (SGND_OUT), U1301.11 (SGND_OUT), U1301.12 (SGND_OUT), U1301.15 (-VOUT), U1301.16 (-VOUT); also elsewhere on the board
/digital-interface3/+5VA_MASTER: C1401.2, C1402.2, D1401.1 (K), R1401.2, TP1401.1, U1401.13 (+VOUT), U1401.14 (+VOUT); also elsewhere on the board
/digital-interface3/GND_MASTER: C1401.1, C1402.1, D1401.2 (A), R1401.1, R1402.1, TP1402.1, U1401.9 (SGND_OUT), U1401.11 (SGND_OUT), U1401.12 (SGND_OUT), U1401.15 (-VOUT), U1401.16 (-VOUT); also elsewhere on the board
GND: C1203.1, C1204.1, C1303.1, C1304.1, C1403.1, C1404.1, R1202.2, R1302.2, R1402.2, U1201.1 (-VIN), U1201.2 (-VIN), U1201.5 (SGND_IN), U1201.6 (SGND_IN), U1201.7 (SGND_IN), U1201.8 (SGND_IN), U1301.1 (-VIN), U1301.2 (-VIN), U1301.5 (SGND_IN), U1301.6 (SGND_IN), U1301.7 (SGND_IN), U1301.8 (SGND_IN), U1401.1 (-VIN), U1401.2 (-VIN), U1401.5 (SGND_IN), U1401.6 (SGND_IN), U1401.7 (SGND_IN), U1401.8 (SGND_IN); also elsewhere on the board

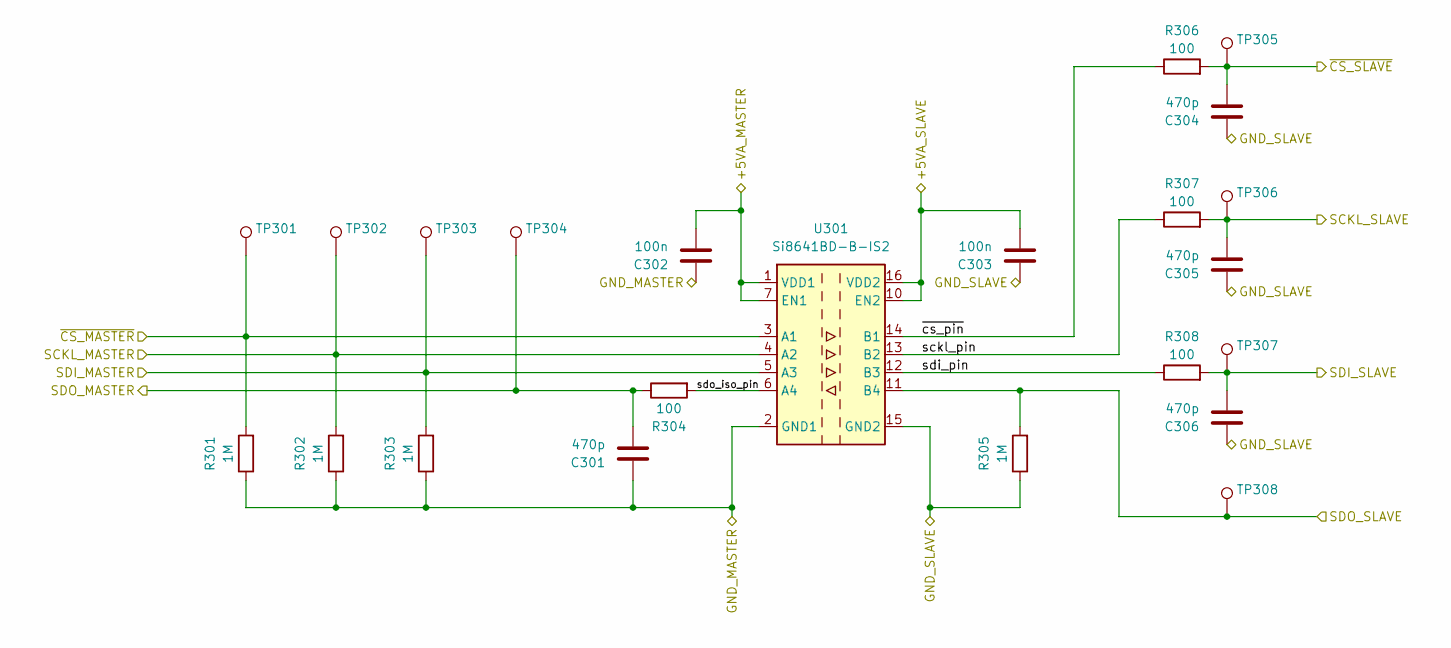
[picture p36: schematic digital-interface.kicad_sch, Measurement]

Parts:
C301, C304, C305, C306: 470p; C_0805_2012Metric_Pad1.18x1.45mm_HandSolder; MPN C0805C471K3RACTU
C302, C303: 100n; C_0805_2012Metric_Pad1.18x1.45mm_HandSolder; MPN C0805C104K3RACTU
R301, R302, R303, R305: 1M; R_1210_3225Metric_Pad1.30x2.65mm_HandSolder; MPN RC1210FR-071ML
R304, R306, R307, R308: 100; R_1210_3225Metric_Pad1.30x2.65mm_HandSolder; MPN RC1210FR-07100RL
TP301, TP302, TP303, TP304, TP305, TP306, TP307, TP308: TP_0805_2012Metric; MPN RCTCTE
U301: Si8641BD-B-IS2; SOIC-16W_7.5x10.3mm_P1.27mm; MPN SI8641BD-B-IS2

Connections:
/+5VA_ISO_I: C303.2, U301.10 (EN2), U301.16 (VDD2); also elsewhere on the board
/GND_ISO_I: C303.1, C304.1, C305.1, C306.1, R305.1, U301.9 (GND2), U301.15 (GND2); also elsewhere on the board
/SCKL: R302.2, TP302.1, U301.4 (A2); also elsewhere on the board
/SDIO1: R303.2, TP303.1, U301.5 (A3); also elsewhere on the board
/SDIO2: C301.2, R304.1, TP304.1; also elsewhere on the board
/adc1/CONVST/~CS: C304.2, R306.2, TP305.1; also elsewhere on the board
/adc1/SCKL: C305.2, R307.2, TP306.1; also elsewhere on the board
/adc1/SDI: C306.2, R308.2, TP307.1; also elsewhere on the board
/adc1/SDO-0: R305.2, TP308.1, U301.11 (B4); also elsewhere on the board
/digital-interface1/sckl_pin: R307.1, U301.13 (B2)
/digital-interface1/sdi_pin: R308.1, U301.12 (B3)
/digital-interface1/sdo_iso_pin: R304.2, U301.6 (A4)
/digital-interface1/~cs_pin: R306.1, U301.14 (B1)
/~CS: R301.2, TP301.1, U301.3 (A1); also elsewhere on the board
GND: C301.1, C302.1, R301.1, R302.1, R303.1, U301.2 (GND1), U301.8 (GND1); also elsewhere on the board

Parts of its further copies:
C201, C204, C205, C206, C401, C404, C405, C406, C501, C504, C505, C506: 470p; C_0805_2012Metric_Pad1.18x1.45mm_HandSolder; MPN C0805C471K3RACTU
C202, C203, C402, C403, C502, C503: 100n; C_0805_2012Metric_Pad1.18x1.45mm_HandSolder; MPN C0805C104K3RACTU
R201, R202, R203, R205, R401, R402, R403, R405, R501, R502, R503, R505: 1M; R_1210_3225Metric_Pad1.30x2.65mm_HandSolder; MPN RC1210FR-071ML
R204, R206, R207, R208, R404, R406, R407, R408, R504, R506, R507, R508: 100; R_1210_3225Metric_Pad1.30x2.65mm_HandSolder; MPN RC1210FR-07100RL
TP201, TP202, TP203, TP204, TP205, TP206, TP207, TP208, TP401, TP402, TP403, TP404, TP405, TP406, TP407, TP408, TP501, TP502, TP503, TP504, TP505, TP506, TP507, TP508: TP_0805_2012Metric; MPN RCTCTE
U201, U401, U501: Si8641BD-B-IS2; SOIC-16W_7.5x10.3mm_P1.27mm; MPN SI8641BD-B-IS2

Connections of its further copies:
/+5VA_ISO_T: C403.2, U401.10 (EN2), U401.16 (VDD2); also elsewhere on the board
/+5VA_ISO_U: C203.2, U201.10 (EN2), U201.16 (VDD2); also elsewhere on the board
/GND_ISO_T: C403.1, C404.1, C405.1, C406.1, R405.1, U401.9 (GND2), U401.15 (GND2); also elsewhere on the board
/GND_ISO_U: C203.1, C204.1, C205.1, C206.1, R205.1, U201.9 (GND2), U201.15 (GND2); also elsewhere on the board
/SCKL: C505.2, R202.2, R402.2, R507.2, TP202.1, TP402.1, TP506.1, U201.4 (A2), U401.4 (A2); also elsewhere on the board
/SDI: C506.2, R203.2, R508.2, TP203.1, TP507.1, U201.5 (A3)
/SDIO1: C201.2, R204.1, TP204.1; also elsewhere on the board
/SDIO2: R403.2, TP403.1, U401.5 (A3); also elsewhere on the board
/SDO: C401.2, R404.1, R505.2, TP404.1, TP508.1, U501.11 (B4)
/adc2/CONVST/~CS: C404.2, R406.2, TP405.1; also elsewhere on the board
/adc2/SCKL: C405.2, R407.2, TP406.1; also elsewhere on the board
/adc2/SDI: C406.2, R408.2, TP407.1; also elsewhere on the board
/adc2/SDO-0: R405.2, TP408.1, U401.11 (B4); also elsewhere on the board
/adc/CONVST/~CS: C204.2, R206.2, TP205.1; also elsewhere on the board
/adc/SCKL: C205.2, R207.2, TP206.1; also elsewhere on the board
/adc/SDI: C206.2, R208.2, TP207.1; also elsewhere on the board
/adc/SDO-0: R205.2, TP208.1, U201.11 (B4); also elsewhere on the board
/digital-interface2/sckl_pin: R407.1, U401.13 (B2)
/digital-interface2/sdi_pin: R408.1, U401.12 (B3)
/digital-interface2/sdo_iso_pin: R404.2, U401.6 (A4)
/digital-interface2/~cs_pin: R406.1, U401.14 (B1)
/digital-interface3/+5VA_MASTER: C502.2, U501.1 (VDD1), U501.7 (EN1); also elsewhere on the board
/digital-interface3/GND_MASTER: C501.1, C502.1, R501.1, R502.1, R503.1, U501.2 (GND1), U501.8 (GND1); also elsewhere on the board
/digital-interface3/SCKL_MASTER: R502.2, TP502.1, U501.4 (A2); also elsewhere on the board
/digital-interface3/SDI_MASTER: R503.2, TP503.1, U501.5 (A3); also elsewhere on the board
/digital-interface3/SDO_MASTER: C501.2, R504.1, TP504.1; also elsewhere on the board
/digital-interface3/sckl_pin: R507.1, U501.13 (B2)
/digital-interface3/sdi_pin: R508.1, U501.12 (B3)
/digital-interface3/sdo_iso_pin: R504.2, U501.6 (A4)
/digital-interface3/~CS_MASTER: R501.2, TP501.1, U501.3 (A1); also elsewhere on the board
/digital-interface3/~cs_pin: R506.1, U501.14 (B1)
/digital-interface/sckl_pin: R207.1, U201.13 (B2)
/digital-interface/sdi_pin: R208.1, U201.12 (B3)
/digital-interface/sdo_iso_pin: R204.2, U201.6 (A4)
/digital-interface/~cs_pin: R206.1, U201.14 (B1)
/~CS: C504.2, R201.2, R401.2, R506.2, TP201.1, TP401.1, TP505.1, U201.3 (A1), U401.3 (A1); also elsewhere on the board
GND: C201.1, C202.1, C401.1, C402.1, C503.1, C504.1, C505.1, C506.1, R201.1, R202.1, R203.1, R401.1, R402.1, R403.1, R505.1, U201.2 (GND1), U201.8 (GND1), U401.2 (GND1), U401.8 (GND1), U501.9 (GND2), U501.15 (GND2); also elsewhere on the board

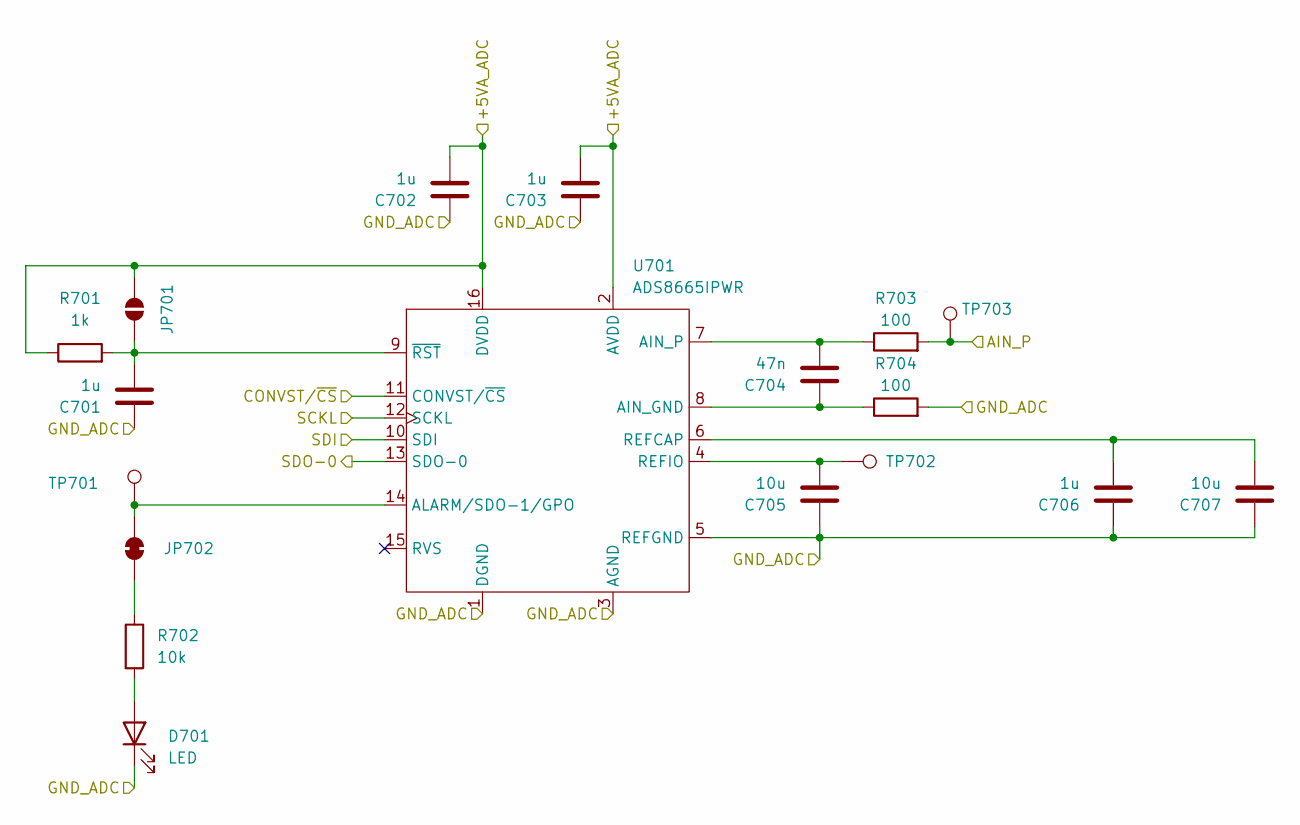
[picture p37: schematic adc.kicad_sch, Measurement]

Parts:
C701, C702, C703, C706: 1u; C_0603_1608Metric_Pad1.08x0.95mm_HandSolder; MPN C0603C105K4RACTU
C704: 47n; C_1206_3216Metric_Pad1.33x1.80mm_HandSolder; MPN C1206C473J5GACTU
C705, C707: 10u; C_1210_3225Metric_Pad1.33x2.70mm_HandSolder; MPN C1210C106K3RACTU
D701: LED; LED_0805_2012Metric_Pad1.15x1.40mm_HandSolder; MPN IN-S85CS5G
JP701: SolderJumper_2_Open; SolderJumper-2_P1.3mm_Open_RoundedPad1.0x1.5mm
JP702: SolderJumper_2_Bridged; SolderJumper-2_P1.3mm_Bridged-Soldermask-Paste_RoundedPad1.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
R701: 1k; R_1210_3225Metric_Pad1.30x2.65mm_HandSolder; MPN RC1210FR-071KL
R702: 10k; R_1210_3225Metric_Pad1.30x2.65mm_HandSolder; MPN RC1210FR-0710KL
R703, R704: 100; R_1210_3225Metric_Pad1.30x2.65mm_HandSolder; MPN RC1210FR-07100RL
TP701, TP702, TP703: TP_0805_2012Metric; MPN RCTCTE
U701: ADS8665IPWR; TSSOP-16_4.4x5mm_P0.65mm; MPN ADS8665IPWR

Connections:
/+5VA_ISO_I: C702.2, C703.2, JP701.1 (A), R701.1, U701.2 (AVDD), U701.16 (DVDD); also elsewhere on the board
/GND_ISO_I: C701.1, C702.1, C703.1, C705.1, C706.1, C707.1, D701.1 (K), R704.2, U701.1 (DGND), U701.3 (AGND), U701.5 (REFGND); also elsewhere on the board
/adc1/AIN_P: R703.2, TP703.1; also elsewhere on the board
/adc1/CONVST/~CS: U701.11 (CONVST/~CS); also elsewhere on the board
/adc1/SCKL: U701.12 (SCKL); also elsewhere on the board
/adc1/SDI: U701.10 (SDI); also elsewhere on the board
/adc1/SDO-0: U701.13 (SDO-0); also elsewhere on the board
unnamed: D701.2 (A), R702.2
unnamed: C701.2, JP701.2 (B), R701.2, U701.9 (~RST)
unnamed: JP702.1 (A), R702.1
unnamed: JP702.2 (B), TP701.1, U701.14 (ALARM/SDO-1/GPO)
unnamed: C704.1, R704.1, U701.8 (AIN_GND)
unnamed: C704.2, R703.1, U701.7 (AIN_P)
unnamed: C706.2, C707.2, U701.6 (REFCAP)
unnamed: C705.2, TP702.1, U701.4 (REFIO)

Parts of its further copies:
C601, C602, C603, C606, C801, C802, C803, C806: 1u; C_0603_1608Metric_Pad1.08x0.95mm_HandSolder; MPN C0603C105K4RACTU
C604, C804: 47n; C_1206_3216Metric_Pad1.33x1.80mm_HandSolder; MPN C1206C473J5GACTU
C605, C607, C805, C807: 10u; C_1210_3225Metric_Pad1.33x2.70mm_HandSolder; MPN C1210C106K3RACTU
D601, D801: LED; LED_0805_2012Metric_Pad1.15x1.40mm_HandSolder; MPN IN-S85CS5G
JP601, JP801: SolderJumper_2_Open; SolderJumper-2_P1.3mm_Open_RoundedPad1.0x1.5mm
JP602, JP802: SolderJumper_2_Bridged; SolderJumper-2_P1.3mm_Bridged-Soldermask-Paste_RoundedPad1.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
R601, R801: 1k; R_1210_3225Metric_Pad1.30x2.65mm_HandSolder; MPN RC1210FR-071KL
R602, R802: 10k; R_1210_3225Metric_Pad1.30x2.65mm_HandSolder; MPN RC1210FR-0710KL
R603, R604, R803, R804: 100; R_1210_3225Metric_Pad1.30x2.65mm_HandSolder; MPN RC1210FR-07100RL
TP601, TP602, TP603, TP801, TP802, TP803: TP_0805_2012Metric; MPN RCTCTE
U601, U801: ADS8665IPWR; TSSOP-16_4.4x5mm_P0.65mm; MPN ADS8665IPWR

Connections of its further copies:
/+5VA_ISO_T: C802.2, C803.2, JP801.1 (A), R801.1, U801.2 (AVDD), U801.16 (DVDD); also elsewhere on the board
/+5VA_ISO_U: C602.2, C603.2, JP601.1 (A), R601.1, U601.2 (AVDD), U601.16 (DVDD); also elsewhere on the board
/GND_ISO_T: C801.1, C802.1, C803.1, C805.1, C806.1, C807.1, D801.1 (K), R804.2, U801.1 (DGND), U801.3 (AGND), U801.5 (REFGND); also elsewhere on the board
/GND_ISO_U: C601.1, C602.1, C603.1, C605.1, C606.1, C607.1, D601.1 (K), R604.2, U601.1 (DGND), U601.3 (AGND), U601.5 (REFGND); also elsewhere on the board
/adc2/AIN_P: R803.2, TP803.1; also elsewhere on the board
/adc2/CONVST/~CS: U801.11 (CONVST/~CS); also elsewhere on the board
/adc2/SCKL: U801.12 (SCKL); also elsewhere on the board
/adc2/SDI: U801.10 (SDI); also elsewhere on the board
/adc2/SDO-0: U801.13 (SDO-0); also elsewhere on the board
/adc/AIN_P: R603.2, TP603.1; also elsewhere on the board
/adc/CONVST/~CS: U601.11 (CONVST/~CS); also elsewhere on the board
/adc/SCKL: U601.12 (SCKL); also elsewhere on the board
/adc/SDI: U601.10 (SDI); also elsewhere on the board
/adc/SDO-0: U601.13 (SDO-0); also elsewhere on the board
unnamed: D601.2 (A), R602.2
unnamed: D801.2 (A), R802.2
unnamed: C601.2, JP601.2 (B), R601.2, U601.9 (~RST)
unnamed: JP602.1 (A), R602.1
unnamed: JP602.2 (B), TP601.1, U601.14 (ALARM/SDO-1/GPO)
unnamed: C801.2, JP801.2 (B), R801.2, U801.9 (~RST)
unnamed: JP802.1 (A), R802.1
unnamed: JP802.2 (B), TP801.1, U801.14 (ALARM/SDO-1/GPO)
unnamed: C604.1, R604.1, U601.8 (AIN_GND)
unnamed: C604.2, R603.1, U601.7 (AIN_P)
unnamed: C606.2, C607.2, U601.6 (REFCAP)
unnamed: C605.2, TP602.1, U601.4 (REFIO)
unnamed: C804.1, R804.1, U801.8 (AIN_GND)
unnamed: C804.2, R803.1, U801.7 (AIN_P)
unnamed: C806.2, C807.2, U801.6 (REFCAP)
unnamed: C805.2, TP802.1, U801.4 (REFIO)

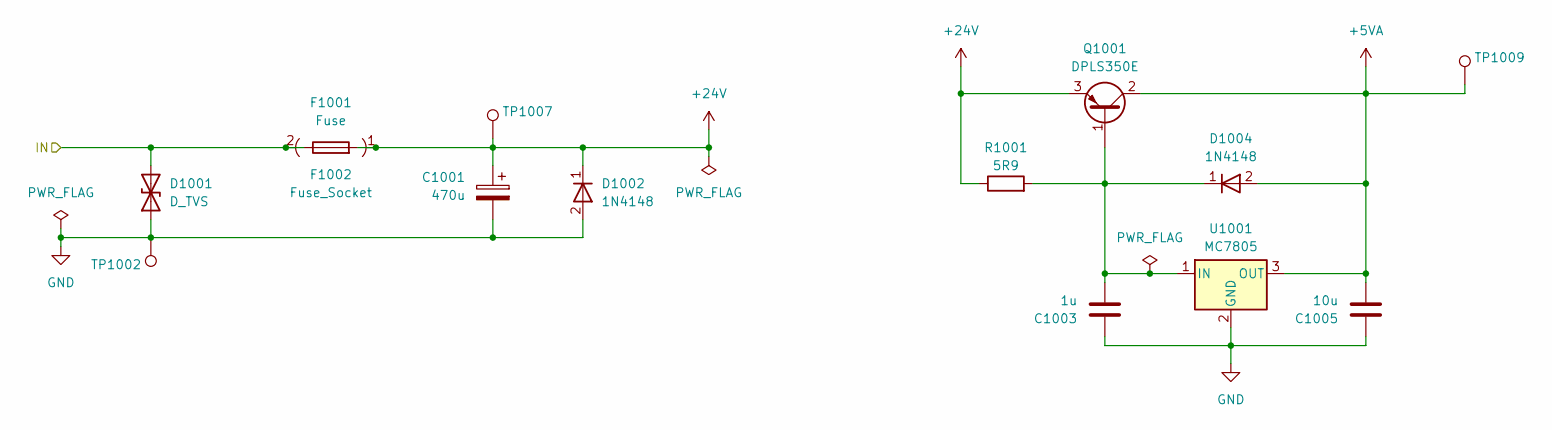
[picture p38: schematic power.kicad_sch, Measurement]

Parts:
C1001: 470u; CP_Elec_10x10; MPN EMZS350ARA471MHA0G
C1003: 1u; C_0603_1608Metric_Pad1.08x0.95mm_HandSolder; MPN C0603C105K4RACTU
C1005: 10u; C_1210_3225Metric_Pad1.33x2.70mm_HandSolder; MPN C1210C106K3RACTU
D1001: D_TVS; D_SOD-323_HandSoldering; MPN UDD32C24L01
D1002, D1004: 1N4148; D_SOD-123; MPN 1N4148W-7-F
F1001: Fuse; MPN 0287001.PXCN
F1002: Fuse_Socket; FuseHolder_Blade_ATO_Littelfuse_FLR_178.6165; MPN 178.6165.0002
Q1001: DPLS350E; SOT-223-3_TabPin2; MPN DPLS350E-13
R1001: 5R9; R_1210_3225Metric_Pad1.30x2.65mm_HandSolder; MPN RC1210FR-075R9L
TP1002, TP1007, TP1009: TP_0805_2012Metric; MPN RCTCTE
U1001: MC7805; TO-252-2; MPN MC7805BDTG

Connections:
+24V: C1001.1, D1002.1 (K), F1001.2, F1002.1, Q1001.3 (E), R1001.1; also elsewhere on the board
/power/IN: D1001.2 (A2), F1001.1, F1002.2; also elsewhere on the board
GND: C1001.2, C1003.1, D1001.1 (A1), D1002.2 (A), TP1002.1, U1001.2 (GND); also elsewhere on the board

Parts of its further copies:
C1002: 1u; C_0603_1608Metric_Pad1.08x0.95mm_HandSolder; MPN C0603C105K4RACTU
D1003: 1N4148; D_SOD-123; MPN 1N4148W-7-F
TP1003, TP1004: TP_0805_2012Metric; MPN RCTCTE

Connections of its further copies:
+24V: TP1003.1; also elsewhere on the board
GND: C1002.1; also elsewhere on the board

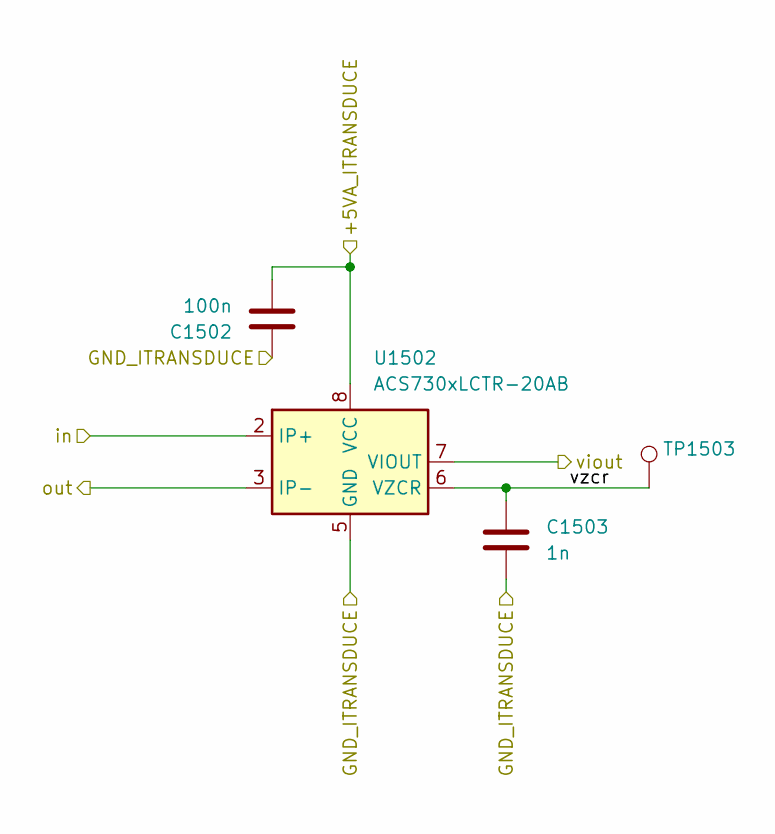
[picture p39: schematic i-transduce.kicad_sch, Measurement]

Parts:
C1502: 100n; C_0805_2012Metric_Pad1.18x1.45mm_HandSolder; MPN C0805C104K3RACTU
C1503: 1n; C_0805_2012Metric_Pad1.18x1.45mm_HandSolder; MPN C0805C102J5GACTU
TP1503: TP_0805_2012Metric; MPN RCTCTE
U1502: ACS730xLCTR-20AB; SOIC-8_3.9x4.9mm_P1.27mm; MPN ACS730KLCTR-20AB-T

Parts of its further copies:
C901: 100n; C_0805_2012Metric_Pad1.18x1.45mm_HandSolder; MPN C0805C104K3RACTU
C902: 1n; C_0805_2012Metric_Pad1.18x1.45mm_HandSolder; MPN C0805C102J5GACTU
TP902: TP_0805_2012Metric; MPN RCTCTE
U901: ACS730xLCTR-20AB; SOIC-8_3.9x4.9mm_P1.27mm; MPN ACS730KLCTR-20AB-T

Connections of its further copies:
/+5VA_ISO_I: C901.2, U901.8 (VCC); also elsewhere on the board
/GND_ISO_I: C901.1, C902.2, U901.5 (GND); also elsewhere on the board
/adc1/AIN_P: U901.7 (VIOUT); also elsewhere on the board
/i-transduce/in: U901.1 (IP+), U901.2 (IP+); also elsewhere on the board
/i-transduce/out: U901.3 (IP-), U901.4 (IP-); also elsewhere on the board
/i-transduce/vzcr: C902.1, TP902.1, U901.6 (VZCR)

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
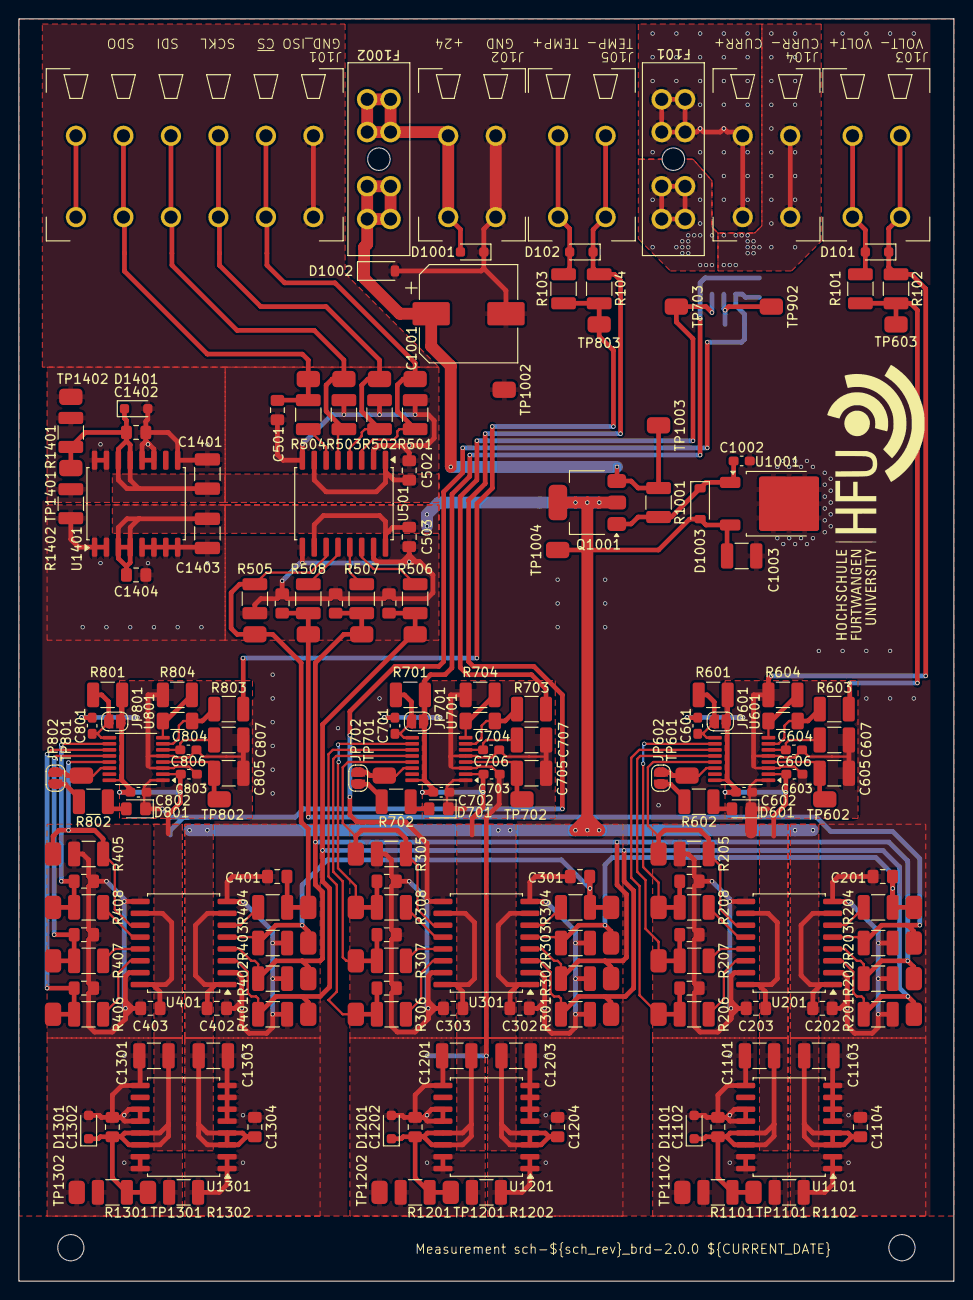
[picture p40: board meas.kicad_pcb from above]

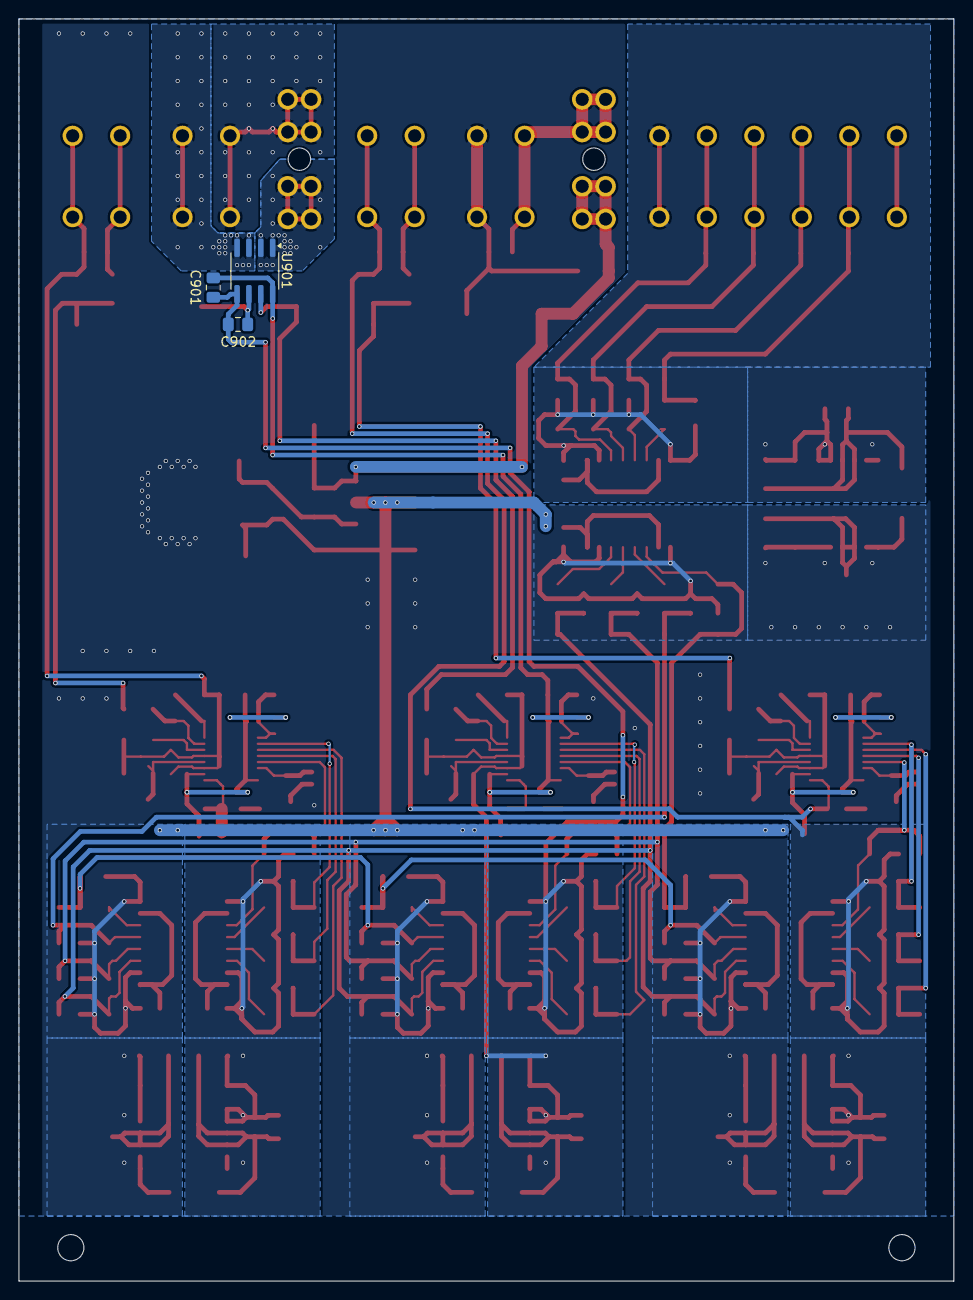
[picture p41: board meas.kicad_pcb from below]

Board: 2 copper layers, 100.0 x 135.0 mm, 215 parts (3 on the bottom side), 84 nets.
