pascalguttmann/obat-meas/iso-dcdc.kicad_pcb

## KiCad design iso-dcdc.kicad_pcb (2025-02-23)

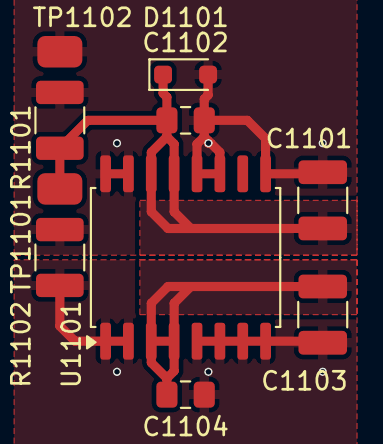
[picture p42: board iso-dcdc.kicad_pcb from above]

Board: 2 copper layers, 10 parts (0 on the bottom side), 4 nets.

Parts:
C1101, C1103: 10u; C_1210_3225Metric_Pad1.33x2.70mm_HandSolder
C1102, C1104: 100n; C_0805_2012Metric_Pad1.18x1.45mm_HandSolder
D1101: PDZ5.6B115; D_SOD-323_HandSoldering
R1101: 330; R_1210_3225Metric_Pad1.30x2.65mm_HandSolder
R1102: 1M; R_1210_3225Metric_Pad1.30x2.65mm_HandSolder
TP1101, TP1102: TP_0805_2012Metric
U1101: R05C05TE05S; SOIC-16W_7.5x10.3mm_P1.27mm

Connections:
/+5VA_IN: C1103.2, C1104.2, U1101.3 (+VIN), U1101.4 (+VIN)
/+5VA_ISO: C1101.2, C1102.2, D1101.1 (K), R1101.2, TP1101.1, U1101.13 (+VOUT), U1101.14 (+VOUT)
/GND_IN: C1103.1, C1104.1, R1102.2, U1101.1 (-VIN), U1101.2 (-VIN), U1101.5 (SGND_IN), U1101.6 (SGND_IN), U1101.7 (SGND_IN), U1101.8 (SGND_IN)
/GND_ISO: C1101.1, C1102.1, D1101.2 (A), R1101.1, R1102.1, TP1102.1, U1101.9 (SGND_OUT), U1101.11 (SGND_OUT), U1101.12 (SGND_OUT), U1101.15 (-VOUT), U1101.16 (-VOUT)
