pascalguttmann/obat-meas/adc.kicad_pcb

## KiCad design adc.kicad_pcb (2025-02-23)

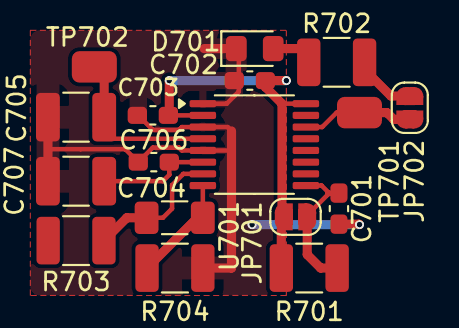
[picture p43: board adc.kicad_pcb from above]

Board: 2 copper layers, 17 parts (0 on the bottom side), 2 nets.

Parts:
C701, C702, C703, C706: 1u; C_0603_1608Metric_Pad1.08x0.95mm_HandSolder
C704: 47n; C_1206_3216Metric_Pad1.33x1.80mm_HandSolder
C705, C707: 10u; C_1210_3225Metric_Pad1.33x2.70mm_HandSolder
D701: LED; LED_0805_2012Metric_Pad1.15x1.40mm_HandSolder
JP701: SolderJumper_2_Open; SolderJumper-2_P1.3mm_Open_RoundedPad1.0x1.5mm
JP702: SolderJumper_2_Bridged; SolderJumper-2_P1.3mm_Bridged-Soldermask-Paste_RoundedPad1.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
R701: 1k; R_1210_3225Metric_Pad1.30x2.65mm_HandSolder
R702: 10k; R_1210_3225Metric_Pad1.30x2.65mm_HandSolder
R703, R704: 100; R_1210_3225Metric_Pad1.30x2.65mm_HandSolder
TP701, TP702: TP_0805_2012Metric
U701: ADS8665IPWR; TSSOP-16_4.4x5mm_P0.65mm

Connections:
/+5VA_ADC: C702.2, C703.2, JP701.1 (A), R701.1, U701.2 (AVDD), U701.16 (DVDD)
/GND_ADC: C701.1, C702.1, C703.1, C705.1, C706.1, C707.1, D701.1 (K), R704.2, U701.1 (DGND), U701.3 (AGND), U701.5 (REFGND)
