pascalguttmann/obat-meas/digital-interface.kicad_pcb

## KiCad design digital-interface.kicad_pcb (2025-02-23)

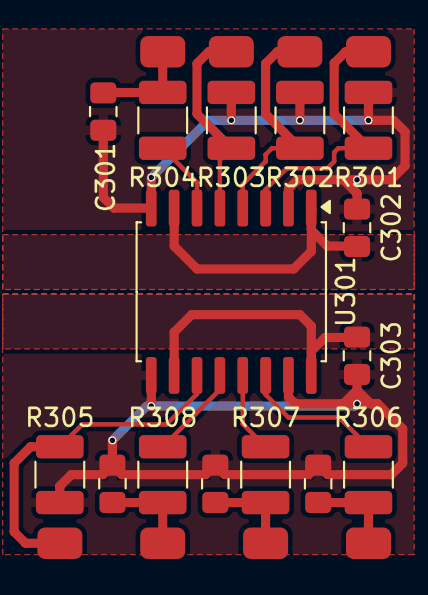
[picture p44: board digital-interface.kicad_pcb from above]

Board: 2 copper layers, 23 parts (0 on the bottom side), 16 nets.

Parts:
C301, C304, C305, C306: 470p; C_0805_2012Metric_Pad1.18x1.45mm_HandSolder
C302, C303: 100n; C_0805_2012Metric_Pad1.18x1.45mm_HandSolder
R301, R302, R303, R305: 1M; R_1210_3225Metric_Pad1.30x2.65mm_HandSolder
R304, R306, R307, R308: 100; R_1210_3225Metric_Pad1.30x2.65mm_HandSolder
TP301, TP302, TP303, TP304, TP305, TP306, TP307, TP308: TP_0805_2012Metric
U301: Si8641BD-B-IS2; SOIC-16W_7.5x10.3mm_P1.27mm

Connections:
/+5VA_MASTER: C302.2, U301.1 (VDD1), U301.7 (EN1)
/+5VA_SLAVE: C303.2, U301.10 (EN2), U301.16 (VDD2)
/GND_MASTER: C301.1, C302.1, R301.1, R302.1, R303.1, U301.2 (GND1), U301.8 (GND1)
/GND_SLAVE: C303.1, C304.1, C305.1, C306.1, R305.1, U301.9 (GND2), U301.15 (GND2)
/SCKL_MASTER: R302.2, TP302.1, U301.4 (A2)
/SCKL_SLAVE: C305.2, R307.2, TP306.1
/SDI_MASTER: R303.2, TP303.1, U301.5 (A3)
/SDI_SLAVE: C306.2, R308.2, TP307.1
/SDO_MASTER: C301.2, R304.1, TP304.1
/SDO_SLAVE: R305.2, TP308.1, U301.11 (B4)
/sckl_pin: R307.1, U301.13 (B2)
/sdi_pin: R308.1, U301.12 (B3)
/sdo_iso_pin: R304.2, U301.6 (A4)
/~CS_MASTER: R301.2, TP301.1, U301.3 (A1)
/~CS_SLAVE: C304.2, R306.2, TP305.1
/~cs_pin: R306.1, U301.14 (B1)
