pascalguttmann/obat-meas/(commit log)

2025-02-22 add .gitignore for KiCad Project
2025-02-22 add 3d_models for pcb rendering
    [178.6165.0000.step, RCTCTE.STEP, pxc_1017503_00_00_TDPT-2-5-2-SP-5-08_3D.stp, pxc_1017507_00_00_TDPT-2-5-6-SP-5-08_3D.stp]
2025-02-22 add kicad project and schematic
    [meas.kicad_sch]
2025-02-22 add digital-interface schematic
    [digital-interface.kicad_pcb, digital-interface.kicad_sch, meas.kicad_sch]
2025-02-22 add adc schematic
    [adc.kicad_pcb, adc.kicad_sch, digital-interface.kicad_sch, meas.kicad_sch]
2025-02-22 add i-transduce schematic
    [adc.kicad_sch, digital-interface.kicad_sch, i-transduce.kicad_sch, meas.kicad_sch]
2025-02-22 fix annotation for imported schematics (page prefix)
    [adc.kicad_sch, digital-interface.kicad_sch]
2025-02-22 add power schematic
    [meas.kicad_sch, power.kicad_sch]
2025-02-22 add overview schematic wiring
    [meas.kicad_sch]
2025-02-22 fix digital-interface schematic connections
    [digital-interface.kicad_sch, meas.kicad_sch]
2025-02-22 add export of symbol libray, edit symbol links
    [adc.kicad_sch, digital-interface.kicad_sch, i-transduce.kicad_sch, meas.kicad_sch, power.kicad_sch]
2025-02-22 add meas.kicad_pcb from template with board outline
    [meas.kicad_pcb]
2025-02-22 add export of footprint library, edit footprint links
    [adc.kicad_sch, digital-interface.kicad_sch, i-transduce.kicad_sch, meas.kicad_pcb, meas.kicad_sch, power.kicad_sch]
2025-02-22 add connector placement
    [meas.kicad_pcb]
2025-02-22 add coarse placement of sub circuits
    [meas.kicad_pcb]
2025-02-22 add adc sub-layout
    [adc.kicad_pcb, meas.kicad_pcb]
2025-02-23 separate digital-interface and iso-dcdc
    [adc.kicad_sch, digital-interface.kicad_pcb, digital-interface.kicad_sch, i-transduce.kicad_sch, iso-dcdc.kicad_pcb, iso-dcdc.kicad_sch, meas.kicad_pcb, meas.kicad_sch]
2025-02-23 add interconnect layout
    [i-transduce.kicad_sch, iso-dcdc.kicad_sch, meas.kicad_pcb, power.kicad_sch]
2025-02-23 fix filled zone netnumbers
    [digital-interface.kicad_sch, iso-dcdc.kicad_pcb, meas.kicad_pcb]
2025-02-23 resize pcb to 100x130 mm^2
    [meas.kicad_pcb, meas.kicad_sch]
2025-02-23 edit silkscreen
    [adc.kicad_pcb, digital-interface.kicad_pcb, iso-dcdc.kicad_pcb, meas.kicad_pcb]
2025-02-23 add plotted exports
    [adc.kicad_sch, digital-interface.kicad_sch, i-transduce.kicad_sch, iso-dcdc.kicad_sch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]
2025-03-06 fix wrong fuse in bom
    [meas.kicad_pcb, power.kicad_sch]
2025-03-06 fix netlist error in schematic and layout
    GND planes of isodcdc and adc of current measurement were not connected and now are connected.
    [adc.kicad_sch, digital-interface.kicad_sch, i-transduce.kicad_sch, iso-dcdc.kicad_sch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]
2025-03-08 change resitor divider for temperature input for higher accuracy
    [adc.kicad_sch, digital-interface.kicad_sch, i-transduce.kicad_sch, iso-dcdc.kicad_sch, meas.kicad_sch, power.kicad_sch]
